sintak15/s3-lora-interface/README.md

# Heltec LoRa Interface

A touchscreen and local web interface for a Heltec Meshtastic radio, built on
an ESP32-S3 CYD. Read messages, check radio and battery status, browse nodes,
and use offline maps without depending on internet access.

**Current firmware: v0.1.112.** The CYD runs this firmware; the Heltec runs
Meshtastic and handles the LoRa radio connection.

Both interfaces use a blue theme with bundled Material Symbols Rounded icons,
rounded cards and consistent navigation feedback. Web Settings opens to five searchable
categories and one editor at a time; Health and SD storage keep detailed
readings under expandable topics. CYD label/value readouts use light blue
labels and white measurements. See the [web UI and display guide](docs/WEB_UI.md).

Battery voltage is measured through an external ADS1115 and a 10k/10k divider.
Only A0 is used for battery sensing; unused A1/A2/A3 are grounded.
Percentage is a rough voltage estimate; no fuel gauge or charging detection is
used. The ATGM336H supplies NMEA positions at 9600 baud. See the
[battery wiring](docs/BATTERY_STATS.md) and [installation checklist](docs/HARDWARE_UPGRADE.md).

## Beginner wiring guide

Follow the [step-by-step beginner wiring guide](docs/WIRING.md) for exact
wire connections, battery-divider assembly, meter checks and troubleshooting
for the build
without DHT22/AM2302, a light sensor, or boosted-5V rail monitoring.
ATGM336H and ADS1115 are the current GPS and battery-sensing hardware.

## Pin mapping — quick reference

For the **LCDWiki 2.8-inch ESP32-S3 CYD** and **Heltec V3.2**. Numbers below
are **GPIO numbers on the named board**, not physical header positions.
All modules share a common ground; UART and I²C signals use 3.3 V logic.

| CYD pin / terminal | Connect to | Purpose |
| --- | --- | --- |
| **GPIO14 — RX** | **Heltec GPIO39 — TX** | Heltec → CYD, 115200 baud |
| **GPIO21 — TX** | **Heltec GPIO38 — RX** | CYD → Heltec, 115200 baud |
| **GPIO3 — GPS RX** | **GPS TX** | GPS → CYD, 9600 baud; positions can be shared over the existing Heltec link |
| **GPIO2** | Leave disconnected | GPS is receive-only; no outside sensor installed |
| **GPIO16 - SDA** | ADS1115 SDA and built-in touch/codec | Shared I2C bus; ADS1115 address 0x48 |
| **GPIO15 — SCL** | ADS1115 SCL; built-in touch/codec | Shared I²C clock |
| **3V3** | ADS1115 VDD | ADC supply and 3.3 V I2C pullups |
| **GND** | Heltec GND, GPS GND and power ground | Common ground |
| **5V** | Boost converter output to CYD/Heltec | GPS VCC must match its breakout input rating |

**Leave GPS RX and Heltec GPIO4 disconnected.** No receiver commands are sent. Enable the Heltec Serial module in **PROTO / Protobuf** mode at
**115200 baud**, with **RX 38 / TX 39**, matching the working Heltec configuration read
on October 25, 2026. The Web UI reads the configured pins or requires both to
be entered explicitly; it does not assume a pair. For CYD GPS sharing, use
**System > GPS > Config > Adv > Use CYD GPS**. The current enclosure has GPS
connected only to the CYD. See [GPS sharing](docs/GPS_SHARING.md) for migration
from the earlier split-wire setup.
See [detailed wiring and battery connections](#wiring) below.

These built-in CYD connections are already routed on the board:

| Built-in function | CYD GPIO assignment |
| --- | --- |
| TFT | CS **10**, DC **46**, MOSI **11**, SCLK **12**, MISO **13**, backlight **45** |
| Touch | SDA **16**, SCL **15**, reset **18**, interrupt **17**; I²C address `0x38` |
| MicroSD | CLK **38**, CMD **40**, D0 **39**, D1 **41**, D2 **48**, D3 **47** |
| Audio clocks | MCLK **4**, BCLK **5**, LRCLK **7** |
| Audio data | **8** ESP32 → codec playback input; **6** codec → ESP32 recording output |
| Audio control | Amplifier enable **1**, active low; codec I²C address `0x18` |

Playback uses GPIO8, matching the
[board schematic](https://www.lcdwiki.com/res/ES3C28P/2.8inch_ESP32-S3_Display_Schematic.pdf).
Connect the speaker to the CYD's dedicated speaker port; these GPIO assignments
describe internal board wiring. See [notification audio](docs/AUDIO.md).

## What it does

- **Home dashboard:** radio status, battery level, node/GPS status and a message
  preview. Tap a card for details, or Menu for the launcher.
- **Messaging:** channel and direct messages, unread counts, delivery states,
  and retry controls where available. Direct messages have per-device conversations
  and drafts on the CYD and web UI.
- **Games:** Tamapetchi and Giraffegotchi beneath a compact live dashboard, plus
  Peanut GB with touch controls and web ROM uploads. See [games](docs/GAMES.md).
- **Notification audio:** soft boops and bubble pops with separate message/direct
  selections, clean volume control, dedicated playback and automatic fault recovery.
- **Offline maps:** SD-backed maps on both the touchscreen and web interface,
  zooms 10–14, feet/miles scales and coarser fallback when detail is missing.
- **Map navigation:** drag to explore, pause/follow the device, recenter and
  inspect actual coverage around the touchscreen map center.
- **Battery monitoring:** ADS1115 cell voltage and approximate percentage; no charging detection or runtime estimate. See [battery monitoring](docs/BATTERY_STATS.md).
- **Local storage:** chat/event logs, position history, saved location and a
  cached map image on FAT32 MicroSD. Supports normal MBR cards and validated
  GPT FAT32 partitions. See [replacement-card verification](docs/SD_REPLACEMENT.md).
- **USB tools:** upload tiles, copy files to a replacement card and inspect
  receiver-level GPS and audio diagnostics.

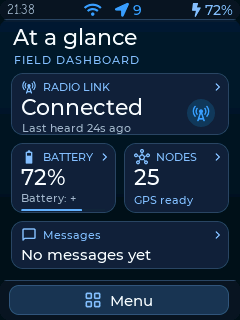
[picture p1: docs/images/home.png]
Touchscreen home dashboard with radio, battery, nodes and messages cards


The launcher contains Messages, Nodes, Map, TX Log, System and Games. Health is under
System. See the [home dashboard guide](docs/HOME_DASHBOARD.md) for details.

## Hardware

The current build uses:

| Component | Purpose |
| --- | --- |
| [LCDWiki 2.8-inch ESP32-S3 display / CYD](https://www.lcdwiki.com/2.8inch_ESP32-S3_Display) | Touchscreen, web interface and SD storage |
| Heltec V3.2 running Meshtastic | LoRa radio |
| ATGM336H GPS breakout and antenna | NMEA location input to CYD |
| ADS1115 breakout, two 10k 1% divider resistors and filter/decoupling capacitors | Battery voltage monitoring |
| Single-cell rechargeable battery, 2500 mAh 18650 in this build | Portable power |
| TP4056 charger and MT3608 5V boost converter | Charging and boosted supply |
| FAT32 MicroSD card, optional | Offline maps and persistent logs |

The verified CYD has 16 MiB flash and 8 MiB PSRAM. Pin assignments below are
specific to this hardware. GPIO numbers are not physical header positions.

## Enclosure

The V4 print set predates the current GPS/ADC hardware. Its mounting envelopes
are historical; check the [ATGM336H/ADS1115 adapters](docs/ENCLOSURE_SENSORS.md)
and verify fit before printing.

[V4 OpenSCAD enclosure](hardware/enclosure/enclosure_v4.scad) uses measured component envelopes,
the single-battery holder, intact power assembly and oval speaker. It provides
visible CYD and Heltec screens, module mounts and separate charging/USB access.
Printed antenna and speaker screw retainers provide mounting without foam.
See the [V4 enclosure guide](docs/ENCLOSURE_V4.md) for previews, exports and
assembly. Print the fit coupon and verify connector/mount offsets before a full
case. The [V3 prototype](docs/ENCLOSURE.md) remains available separately.

Latest fit revisions (earlier STL iterations are retained for reference):

Enclosure sources, printable files and fit coupons are grouped under
[`hardware/enclosure/`](hardware/enclosure/README.md).

- [Current face: tapered GPS supports and 1.8 mm CYD pilots](hardware/enclosure/enclosure-v4-front-gps-tapered-rims.stl).
- [Current base plus two Heltec brackets on one 180 mm plate](hardware/enclosure/enclosure-v4-latest-base-and-heltec-brackets.stl).
- [Existing base alone: breakout screw posts and open battery area](hardware/enclosure/enclosure-v4-base-max-screw-posts.stl).
- [Matching antenna brackets](hardware/enclosure/enclosure-v4-antenna-rails-repair.stl).
- [Speaker retaining frame](hardware/enclosure/enclosure-v4-speaker-frame.stl).

Print at 100% scale in millimetres, keeping the supplied bed orientation.
See the [latest face notes](docs/GPS_TAPERED_RIMS.md) and
[base mounting notes](docs/MAX_SCREW_POSTS.md) for screw sizes and fit checks.
The current designs have geometry checks but are still physical-fit prototypes.

## Build and first connection

1. Install the pinned Arduino dependencies and board configuration from
   [docs/BUILD.md](docs/BUILD.md). LVGL and TFT_eSPI configuration files are
   included in the repository.
2. To customize the device identity and credentials, copy
   `config/device_config.example.h` to `config/device_config.local.h` and edit
   that local file. Git ignores it. Without it, the example configuration is used.
3. Wire and configure the Heltec serial connection as shown below. Enable its
   GPS and configure the GPS pins if the receiver is installed.
4. Build the CYD firmware without changing its version:

   ```powershell
   .\tools\build_ota_bin.ps1 -NoVersionBump
   ```

   The binary is written under `dist/`. You can also use Arduino IDE with the
   board settings documented in the build guide.
5. Flash the CYD, connect to its Wi-Fi access point, and open
   **http://192.168.4.1/**. In station mode, use its assigned local-network address.

With the unchanged example configuration, the Wi-Fi network is
`s3-lora-interface`, the Wi-Fi password is `setup1234`, and the web login is
`admin` / `setup1234`. Complete the first-run setup and change the password.
Custom configurations use their configured network name and credentials.

The web interface includes messaging, nodes, offline maps, health, settings,
SD downloads and firmware upload. The map library and stylesheet are bundled
in firmware, so the web map needs no internet access.

## Wiring

TX connects to RX: one board's transmit wire goes to the other's receive pin.
All boards share a common ground.

### Power and battery monitoring

The documented power path is battery → charger output → 5V boost converter.
The boosted rail supplies the Heltec `5V`, CYD `5V` and the GPS breakout only if its input rating permits 5 V. The CYD USB port does not charge this project's battery; charging uses
the separate charger connection.

Battery sensing uses an external ADS1115 at 0x48 and a 10k/10k divider on A0.
[Wiring and power-off checks](docs/BATTERY_STATS.md) require no CYD modifications.
Keep the CYD battery socket empty while using the external charger.

### CYD ↔ Heltec serial

| CYD | Heltec |
| --- | --- |
| GPIO14 — RX | GPIO39 — TX |
| GPIO21 — TX | GPIO38 — RX |
| GND | GND |

In the Meshtastic serial module, set **Enabled**, **PROTO / Protobuf** mode,
**115200 baud**, **RX pin 38** and **TX pin 39** for this wiring.

### Unused sensor connections

Leave GPIO2 disconnected and ground ADS1115 A1/A2/A3. No outside sensor,
light sensor or 5V monitoring divider is installed. Disable absent outside-sensor
polling with `AM2302_DATA_PIN=-1` in the local configuration; see the
[core wiring guide](docs/WIRING.md).

### GPS

ATGM336H TX connects to CYD GPIO3; GND connects to common system ground.
Leave GPS RX and CYD GPIO2 disconnected. Default is 9600 baud, 8N1, receive-only
NMEA. Supply voltage must match the purchased BREAKOUT's documented rating;
never assume a bare ATGM336H supports 5 V. Confirm its regulator/input labels
before reusing the old GPS supply wire.

Enable **Use CYD GPS** only after checking the Heltec setup as described in
[GPS sharing](docs/GPS_SHARING.md). Position sharing remains available. Receiver
rate/model/power/SBAS/save controls are disabled for ATGM336H; no u-blox commands
are sent. See [GPS configuration](docs/GPS_CONFIG.md),
[GPS diagnostics](docs/GPS_DIAGNOSTICS.md) and
[the installation checklist](docs/HARDWARE_UPGRADE.md).

### Built-in MicroSD slot

| SD signal | CYD GPIO |
| --- | --- |
| CLK | 38 |
| CMD | 40 |
| D0 | 39 |
| D1 | 41 |
| D2 | 48 |
| D3 | 47 |

Use the CYD's built-in slot. These are CYD GPIO assignments, separate from
the similarly numbered Heltec pins.

## Offline maps

Place tiles on the SD card using this structure:

```text
/s3-lora/tiles/{zoom}/{x}/{y}.rgb565
```

Each tile is **256×256 RGB565, little-endian, exactly 131072 bytes**. Supported
zoom levels are **10–14**; lower numbers show a wider area. Preparing new maps
requires a suitable tile source; viewing installed maps is fully offline.

On the touchscreen, use −/+ to change zoom, drag to explore, and use Follow
or My location to resume tracking. Coverage reports installed tiles around the
current center at each level. The requested zoom is retained when a coarser
view is needed. Availability is checked from files, not inferred from a
download plan.

The browser uses the same SD tiles. It preserves your pan position during
status updates and provides My location, Show nodes and Refresh maps controls.
Its Touchscreen coverage card describes the touchscreen's last checked area;
the browser map has its own visible-tile status.

See [touchscreen navigation](docs/MAP_NAVIGATION.md),
[coverage and fallback](docs/MAP_COVERAGE.md), and
[offline browser maps](docs/WEB_OFFLINE_MAPS.md).

### Upload tiles over USB

Install `pyserial`, connect through the **CYD USB port**, and close other serial
monitors. Replace `COM12` and `H:` with the actual port and card-reader drive.

```powershell
python -m pip install pyserial
python tools/upload_tiles_usb.py --port COM12 --tiles H:\s3-lora\tiles
```

The tile folder must contain `z/x/y.rgb565`. Identical tiles are verified and
skipped; add `--overwrite` to replace different existing tiles. Transfers use
CRC checks and SD readback verification. Use `--dry-run` to validate local
paths and sizes without connecting.

For large map packs, downloading directly to a card in a USB reader avoids the
CYD transfer step. The USGS downloader supports resuming and a storage budget,
with a St. Paul-centered coverage profile. See the
[map transfer and replacement-card guide](docs/USB_MAP_TRANSFER.md) for tile
preparation, direct downloads, source attribution and safe stopping/resuming.

### Preserve files when changing cards

To copy supporting files while preparing a new map pack separately:

```powershell
python tools/copy_sd_usb.py --port COM12 --destination H:\ `
  --manifest build/sd-copy-H.jsonl --progress build/sd-copy-H.json `
  --exclude-path /s3-lora/tiles
```

This reads the installed card and preserves directory structure on the new
card. Omit `--exclude-path` to copy existing tiles too. Supporting files can
include chat history and saved locations. Shut down the CYD before swapping
cards, and keep the original card until the replacement is working.

## GPS diagnostics

Open **System → GPS** to inspect receiver bytes, valid NMEA sentences,
checksum errors and available satellite counts before a position fix. Unknown
satellite counts are distinct from zero.

Over the CYD USB connection, the `gps` command reports the same receiver health
and the Heltec's reported GPS pin settings. To record an observation:

```powershell
python tools/gps_diagnostics_usb.py --port COM12 --duration 35 --interval 5 `
  --output build/gps-observation.json
```

The packet-statistics **GPS / Positions** counter measures mesh position
messages, including other nodes. It is not a receiver-fix counter.

| Observation | Next checks |
| --- | --- |
| Receiver bytes stay at zero | GPS power, common ground and GPS TX → CYD GPIO3 |
| Bytes arrive, but valid NMEA does not increase | Baud rate, output protocol and signal integrity |
| Valid sentences arrive, but no fix | Outdoor sky visibility, antenna connection/orientation and GPS supply stability |

The latest recorded observation confirmed valid serial data and the expected
Heltec pin settings, but did **not** acquire a position fix. See
[GPS diagnostics and recorded findings](docs/GPS_DIAGNOSTICS.md) for details.

## Memory and development

Large UI buffers, logs and the map canvas use ESP32-S3 PSRAM. The optional
eight-tile cache holds **1 MiB** in PSRAM; display transfer buffers and task
stacks remain in internal RAM. See the
[measured cache profile](docs/MAP_CACHE_PROFILE.md) for timings and limits.

Build dependencies, verification commands, source layout and hardware checks
are documented in [docs/BUILD.md](docs/BUILD.md). Local device configuration,
generated build identity, binaries, logs and download progress remain outside
Git under the configured ignore rules.

See the [documentation index](docs/README.md) for current guides and historical
reviews, and [contribution conventions](CONTRIBUTING.md) for naming, file
placement and verification before committing.

The bundled Leaflet viewer retains its license in
[src/vendor/leaflet/LICENSE](src/vendor/leaflet/LICENSE).
