sintak15/s3-lora-interface/docs/README.md

# Documentation index

The [project README](../README.md) contains the hardware overview, wiring and
first connection. These guides describe the current firmware unless marked as
historical.

## Hardware wiring

- [Beginner wiring: exact connections, battery divider, meter checks and troubleshooting](WIRING.md)
- [Expanded sensor installation checklist](HARDWARE_UPGRADE.md)

## Firmware and operation

- [Build, verification and source layout](BUILD.md)
- [Web navigation, rounded icons, blue theme and CYD label/value colors](WEB_UI.md)
- [Notification boops, pops and audio diagnostics](AUDIO.md)
- [ADS1115 battery voltage and approximate percentage](BATTERY_STATS.md)
- [GPS Config and Adv settings](GPS_CONFIG.md)
- [CYD GPS sharing and removing the split wire](GPS_SHARING.md)
- [GPS wiring, diagnostics and USB control](GPS_DIAGNOSTICS.md)
- [Heltec firmware updates and installed-loader limits](HELTEC_UPDATES.md)
- [Home dashboard](HOME_DASHBOARD.md)
- [Touchscreen map navigation](MAP_NAVIGATION.md)
- [Offline coverage and fallback](MAP_COVERAGE.md)
- [Tile cache and measured performance](MAP_CACHE_PROFILE.md)
- [Offline browser maps](WEB_OFFLINE_MAPS.md)
- [USB map transfer, replacement cards and resumable downloads](USB_MAP_TRANSFER.md)
- [Naming, file placement and contribution checks](../CONTRIBUTING.md)

## Enclosure and printing

Start with the [enclosure file index](../hardware/enclosure/README.md) for current
print parts, earlier variants and fit coupons. The
[V4 enclosure guide](ENCLOSURE_V4.md) describes the mechanical assembly;
[paper templates and fit trays](fit-template/3D-PRINT.md) support fit checks.

## Historical records

These retain the observations, version and limitations recorded at the time.
Line references in dated reviews refer to that reviewed source revision.

- [Heltec message/restart investigation — October 24, 2026](MESSAGE_RESTART_REVIEW_2026-10-24.md)
- [Firmware implementation history](FIRMWARE_HISTORY.md)
- [Project review — October 23, 2026](PROJECT_REVIEW_2026-10-23.md)
- [Audio investigation — October 23, 2026](AUDIO_REVIEW_2026-10-23.md)
- [Photo and mechanical-fit review — October 21, 2026](PHOTO_FIT_REVIEW_2026-10-21.md)
- [V3 enclosure prototype](ENCLOSURE.md)
