sintak15/s3-lora-interface/docs/GPS_SOLID_RIMS.md

# Filled NEO-6M post rims

Historical mechanical revision: these dimensions describe earlier hardware.
For current ATGM336H/ADS1115 connections use the [wiring guide](WIRING.md);
verify replacement-module fit with the [adapter guide](ENCLOSURE_SENSORS.md).

Full face: `hardware/enclosure/enclosure-v4-front-gps-solid-rims.stl`.
Small test: `hardware/enclosure/enclosure-v4-gps-solid-rims-coupon.stl`.

The two screenshot-marked recesses beside the NEO-6M screw holes are filled.
The receiver posts have full 6 mm outside-diameter caps from Z=13.6 to their
unchanged Z=18 seating plane, except for the intended 1.6 mm screw pilots.
All 3.2 mm of pilot depth is enclosed by the solid caps; nominal radial wall
around the pilot is 2.2 mm (slightly flattened on the adjacent CYD side).

Lower recesses remain for the complete 25 × 25 × 7.5 mm antenna and its feed.
The flat antenna sits at Z=3.8–11.3; feed relief extends to 13.3, with another
0.3 mm allowance before the filled cap starts. The rest of the right-shifted
layout and all board mounting centres and heights remain unchanged.

Use current M2 × 4 mm NEO-6M screws. Existing antenna brackets and the latest
base remain compatible. The newly filled caps have underside overhangs:
inspect the layer preview and use local supports under these caps as needed.
Print exterior face down, 100% scale, 0.2 mm layers and 4 walls. Keep support
out of the pilot holes. Physical fit and strength have not been load tested.
