sintak15/s3-lora-interface/docs/WEB_UI.md

# Web UI and display

Firmware uses a navy/blue palette on both the CYD and its local web UI.
Open the CYD's IP address in a browser and use its configured web login.

## Theme and icons

v0.1.104 adds Material Symbols Rounded to the home dashboard, main navigation,
system menus and page headings, with matching icons in web navigation, Settings
categories, status cards and diagnostic topics. Every navigation control keeps
its text label. The CYD main menu keeps all six destinations on one screen;
denser system menus scroll to accommodate an icon above each full-width label.

Cards, panels and buttons share rounded corners and blue pressed/selected states.
CYD press feedback changes colors without enlarging touch targets. Browser
transitions respect the operating system's reduced-motion preference. The larger
text modes, blue diagnostic labels/white readings, amber/red warnings, plain
battery symbols and message-direction colors remain in place.

Icons are bundled in firmware and work offline. The browser uses inline SVGs;
the CYD uses 16/20/24-pixel alpha masks, so there is no runtime SVG decoder or
external font download. Only 28 selected icons are included, using 17,248 bytes
of pixel masks before metadata. The unchanged source SVGs, pinned upstream
commit, hashes and Apache 2.0 license are in
[the Material Symbols directory](../src/vendor/material-symbols/README.md).
Regenerate both asset formats with `python tools/generate_ui_icons.py`; add
`--check` to verify them. Generation requires Pillow, Playwright and Chromium.

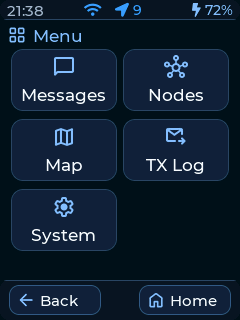
[picture p4: docs/images/menu.png]
CYD main menu with rounded blue icon tiles and readable labels


## Finding settings

**Settings** is a main navigation destination. Its landing page offers five
categories rather than displaying every configuration field:

| Category | Editors |
| --- | --- |
| Radio & location | Radio/identity, channels, GPS/position |
| Device & screen | CYD interface, Heltec behavior, Heltec display, Heltec power |
| Connections | Heltec Wi-Fi, Bluetooth, serial link, MQTT |
| Messages & alerts | External alerts, store/forward, canned messages, status message |
| Sensors & tools | Telemetry, detection sensor, ambient LED, Heltec voice audio, Paxcounter, neighbor information, range test |

Choose a category, then an editor. Only that editor is shown. **All settings**
returns to the category list; the category button returns to its section list.
Search finds sections by their titles, descriptions and field labels. Selecting
a result also opens an advanced group when the matching field is inside it.
Changing editors keeps drafts in the browser, including pending passwords.
Background status updates do not erase those drafts.

The CYD interface editor controls the CYD's identity, access point and web login.
Editors explicitly named Heltec control the connected Meshtastic radio. Heltec
voice audio is separate from the CYD's notification sounds.

Common fields appear first. Advanced groups hold GPS timing, serial pins, sleep
timings, display details, MQTT extras, notification outputs and telemetry
reporting intervals. Their values still load from the radio and remain included
when their section is applied. Blank password fields retain existing secrets.
Apply/save feedback appears above the active editor. A lost connection reports
an unknown outcome; refresh settings before repeating the change.

Serial RX/TX fields start blank until valid Heltec configuration is received.
If the link is down, enter both pins to match the wiring. Applying the serial
module never substitutes a default pin pair; requests missing either pin are
rejected. Background refreshes preserve edited pins until matching radio
readback arrives. GPS sharing accepts distinct, nonzero configured RX/TX pins
with PROTO at 115200 baud and a responsive radio link.

Channel Save remains in its editor. General save/restart and diagnostic commands
are under **Tools > Serial console > Heltec commands**.

## Health and maintenance

**Tools** contains Health & diagnostics, SD storage, event logs, serial console
and firmware update. The menu closes when a destination is selected, when
Escape is pressed or when another part of the page is clicked.

Health initially shows eight essential readings. Battery/runtime, GPS/position,
radio traffic/serial data, maps/cache, system resources and audio/hardware tests
have separate expandable topics. Field reports remain directly downloadable.
SD storage initially shows status, type, usage and capacity; saved files and
maintenance counters have their own expandable groups.

The Battery & runtime topic shows Battery: +, Battery: - and
Battery: = indicators, sampled voltage variation and automatic logging status.
The retention checkbox rotates after 48 hours of powered-on recording; disabling
it keeps the current log growing. Current and previous readable/CSV downloads
remain available. On the CYD, **System > Battery > View logs** opens a scrollable
recent log with **Current log**, **Previous log** and **Refresh log** controls.
See [battery statistics](BATTERY_STATS.md) for retention and measurement limits.

## Clear controls and message direction

Use plain action-and-object labels that explain the result of tapping a control.
When space is tight, use a separate page or a short visible explanation instead
of an ambiguous abbreviation. Settings that change retention must say so and
remain separate from the automatic measurement status. This is the standing
labeling preference for future interface changes.

Public, secondary-channel and direct-message histories use light blue
(`#85BFFF`) for this device's messages and white (`#F4F8FF`) for messages from
other devices. A visible web legend explains the colors, and persisted sender
labels remain readable without color. New incoming entries are marked `from`
and outgoing/local-echo entries use `me`, based on the actual node direction.
A remote node named `me` is still an incoming entry. Multiline content remains
part of its original message, and literal HTML/LVGL color commands are escaped.
Raw SD message logs keep plain text; colors are applied only while displaying.

## CYD label/value colors

Structured readouts use light blue (`#85BFFF`) for the label, including its
colon, and white (`#F4F8FF`) for the reading on the same line. For example,
**Charge rate:** and **3.14%/hr** have different colors. This covers battery,
GPS, Wi-Fi, interface/memory/SD statistics, serial/radio statistics, mesh health,
node details, message diagnostics, channel readouts, map coverage, brightness,
sound volume and receiver-current-setting readouts. Existing warning/fault
indicators retain amber/red. The palette also covers home cards, navigation,
inputs, keyboard, node lists and map markers; map imagery keeps its source colors.

The shared `DiagnosticText` formatter distinguishes field-label colons from
colons inside MAC addresses and times. It also handles multiple label/value
pairs on a line. Literal `#` characters in values are escaped before LVGL
recoloring, so SSIDs and node names remain literal data. Formatting uses a
bounded shared UI buffer; an oversized future readout falls back to complete
plain text rather than truncating its measurements. Editable inputs and freeform
message/log bodies retain ordinary text handling.

## Verification

v0.1.104 passed all 74 actual-device layout cases across both text modes,
including icon bounds, diagnostic screens, long Home states and detailed node
rows. The native Home, navigation and scroll checks passed. Browser checks at
390 and 1280 pixels verified icons inside their controls, accessible text labels,
reduced-motion styling, retained edits, offline maps and diagnostic colors.
Read-only checks against the installed device also passed at both widths, with
no browser errors or external asset requests. Updated Home/menu images were
captured from pixels sent to the CYD display.

Production v0.1.104 was installed over Wi-Fi on October 24, 2026. The radio link
returned responsive, continuous SD recording resumed, and gauge/radio/audio/SD
error counters remained zero in the final check. CYD preferences and cached
Heltec/channel configuration matched the pre-update snapshot. The installed
HTML matched the reviewed source, and verification-only inspection routes
returned 404. The production image is
`dist/s3-lora-interface-rounded-theme-v0.1.104-20261024.bin` (1,928,544 bytes),
SHA-256 `b8668ae06626f75d575dcd9201c146b72943fb7b55a61c5130b62e6191d01d28`.

The original live v0.1.96 Settings page exposed 158 controls, including a single
46-control additional-modules form. It measured 15,366 pixels tall at 390 px
width. The new landing page shows five categories, retains all existing controls
across 22 editors, and measures under 1,500 pixels in the browser layout checks.

`tests/test_web_navigation.py` exercises desktop/mobile navigation, advanced
search results, all editors, draft/secret preservation, module save requests,
the channel shortcut, grouped diagnostics, label/value colors, UTF-8 symbols and
the initial-password setup restriction. Existing browser tests cover status
polling, escaping, retries, sound previews and offline maps. Compile-time
`DiagnosticTextTests.h` checks label boundaries, literal data and buffer limits.
See [build and verification](BUILD.md) for the commands.

### Installed-device verification

On October 23, 2026, v0.1.97 was installed over authenticated Wi-Fi on
`192.168.1.192`. The CYD booted from `app1`; its radio link remained responsive,
SD storage was available, and its local GPS had a fresh fix with ten satellites.
Reported CYD identity, network and sound preferences, the cached Heltec
configuration and channel summaries matched the snapshot taken before upload.

Read-only browser checks against the installed device passed at 390 px and
1,280 px widths: category navigation, one visible editor, advanced-field search,
eight summary diagnostics and the blue-label/white-value colors. The mobile
Settings landing page measured 1,150 px, versus the previous 15,366 px. Neither
viewport produced JavaScript errors or configuration writes. The firmware build,
compile-time readout tests, web regressions and offline-map browser checks also
passed. The physical CYD display has not been visually inspected for this release.

GPS sharing reported **Use CYD GPS setup required** both before and after this
update: the Heltec's existing position configuration had GPS mode `ENABLED`.
The UI update preserved that configuration; it did not rerun the GPS-sharing
setup or verify new relay acknowledgements. Local CYD GPS reception was working.

The installed application is 1,871,040 bytes; its SHA-256 is
`81923f511a5de53aa77e536fffa12e296425a16d7b195332f6c9b901df4ab821`.

## Stable scrolling and text sizing (v0.1.102)

CYD live readouts wait while a finger is down, until scrolling momentum ends,
and while an options dropdown is open.
Nodes refreshes keep the visible node and its offset, including when new nodes
sort above it or compact/detail row heights change. Removing an anchor clamps
the old position to the available content. Changing Sort/Filter or explicitly
clearing the list starts at the top. Returning from node details keeps position.

Pages own vertical scrolling; decorative panels pass drags to the page and
readout panels grow with their text. Touch focus no longer scrolls a button into
view. Pages, lists and read-only text avoid elastic overscroll. Chat follows new
messages while at the bottom and preserves position when reading older entries.

Default text is one pixel larger: CYD Comic Neue 12/14 becomes 13/15 px, and
Readable mode Montserrat 14/16 becomes 15/17 px. Home small text becomes 11 px
and message previews 15 px; large dashboard headings retain their separate size.
Web text sizes also increase by one CSS pixel. Battery symbols use regular weight.

## Games and direct conversations (v0.1.107)

**Games** lists SD Game Boy ROMs and accepts authenticated `.gb` uploads up to
4 MiB. Uploads validate names, cartridge headers and declared size before an
atomic rename. Existing ROMs require explicit deletion before replacement;
deleting a ROM retains its save file. See [games](GAMES.md) for paths and limits.

**Messages > Direct** selects a particular peer, shows its recent history and
keeps its draft. Changing peers also changes the reply recipient. Late responses
for an earlier selection cannot replace the visible conversation. Reading one
conversation marks only that peer read. Old mixed history remains available as
**Earlier messages**.

Authenticated `GET /sd/list?path=/&cursor=0` provides a paginated directory
listing (64 entries per page); `GET /sd/file?path=/...` exports a file. These
read-only routes support copying existing data to a replacement card while
preserving a newly downloaded map pack. They do not modify the old card.
