sintak15/s3-lora-interface/hardware/enclosure/sensors-exploded.png

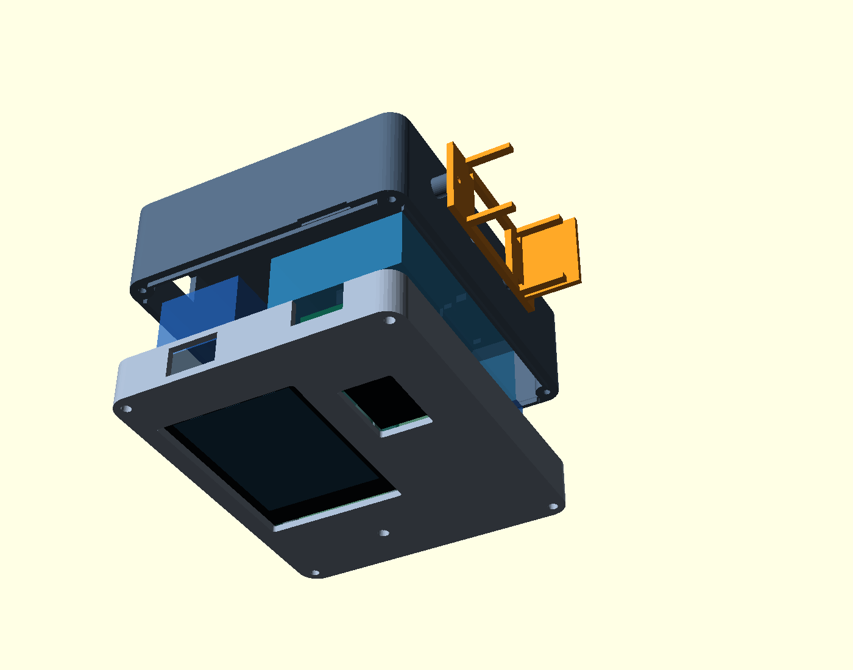
hardware/enclosure/sensors-exploded.png
