sintak15/s3-lora-interface/hardware/enclosure/enclosure-v4-remaining-parts.stl

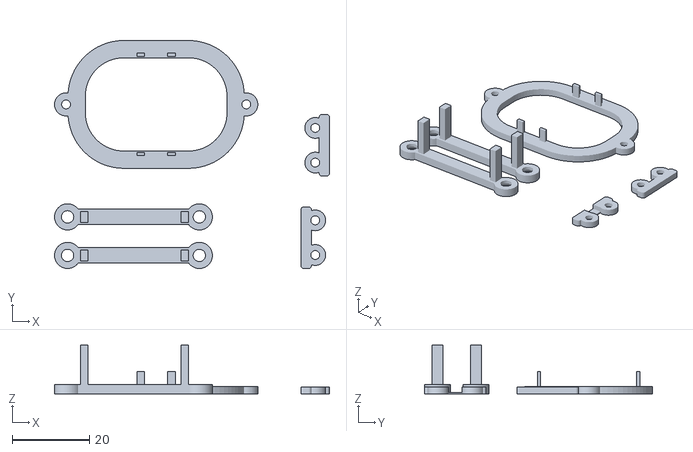
[picture p8: CAD file, 2026-10-23]
hardware/enclosure/enclosure-v4-remaining-parts.stl
71.4 x 59.2 x 12.7
