sintak15/s3-lora-interface/enclosure-v4-antenna-ledges-coupon.stl

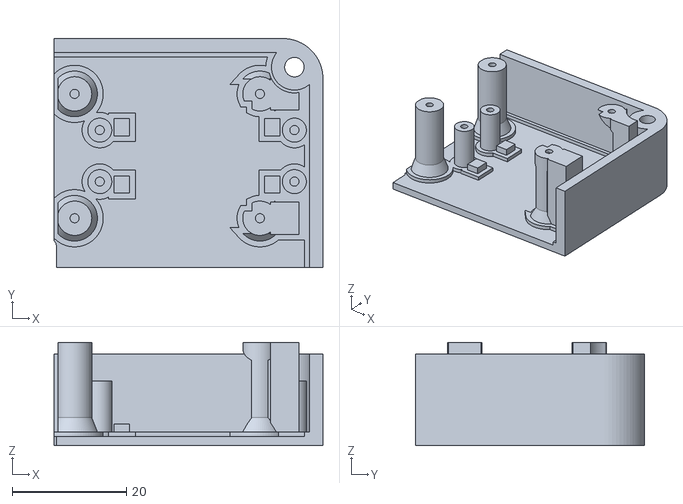
[picture p9: CAD file, 2026-10-23]
enclosure-v4-antenna-ledges-coupon.stl
47.0 x 40.0 x 18.0
