sintak15/s3-lora-interface/fit-coupons/all-coupons-labeled-180mm.stl

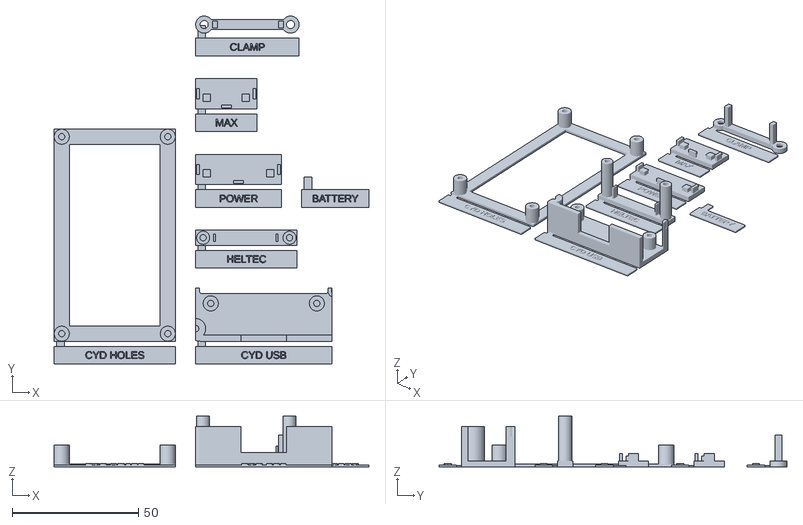
[picture p10: CAD file, 2026-10-23]
fit-coupons/all-coupons-labeled-180mm.stl
124.6 x 137.8 x 20.1
