sintak15/s3-lora-interface/fit-coupons/lightweight/heltec_clamp.stl

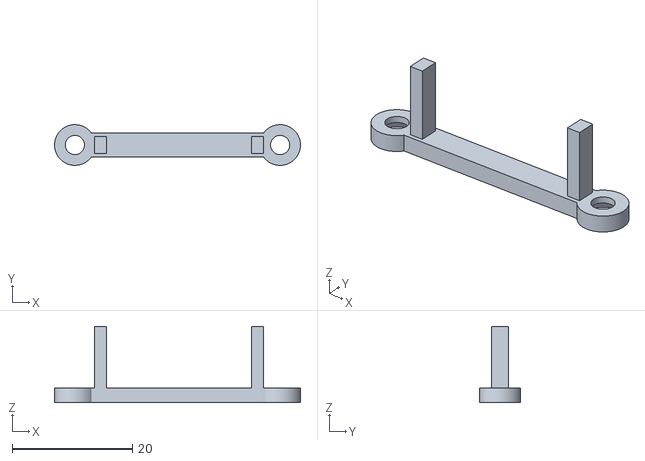
[picture p11: CAD file, 2026-10-23]
fit-coupons/lightweight/heltec_clamp.stl
41.0 x 6.80 x 12.7
