sintak15/s3-lora-interface/hardware/enclosure/fit-coupons/all-coupons-180mm.stl

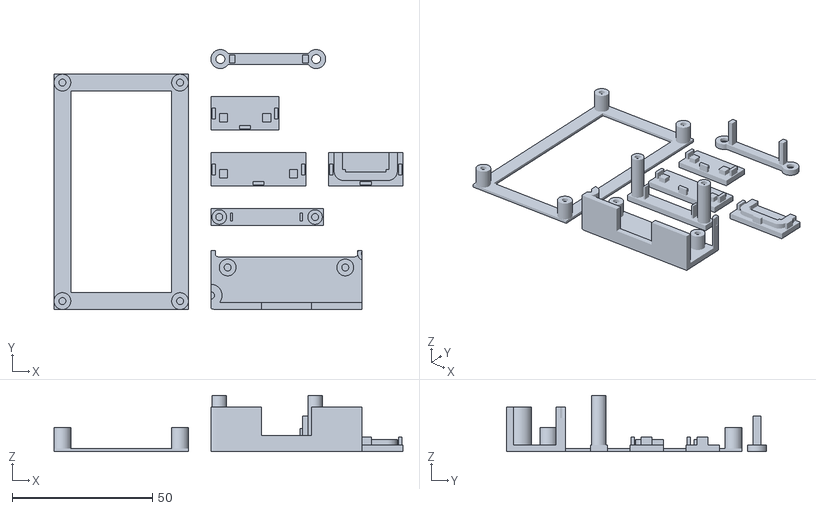
[picture p12: CAD file, 2026-10-23]
hardware/enclosure/fit-coupons/all-coupons-180mm.stl
124.6 x 92.8 x 20.1
