sintak15/s3-lora-interface/hardware/enclosure/fit-coupons/labeled/power.stl

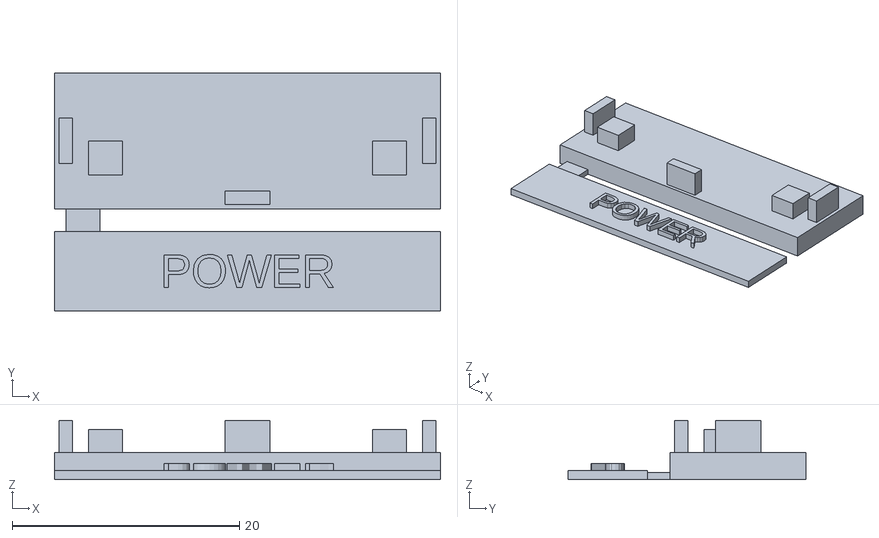
[picture p13: CAD file, 2026-10-23]
hardware/enclosure/fit-coupons/labeled/power.stl
34.0 x 21.0 x 5.20
