sintak15/s3-lora-interface/hardware/enclosure/fit-coupons/lightweight/all-coupons-labeled-180mm.stl

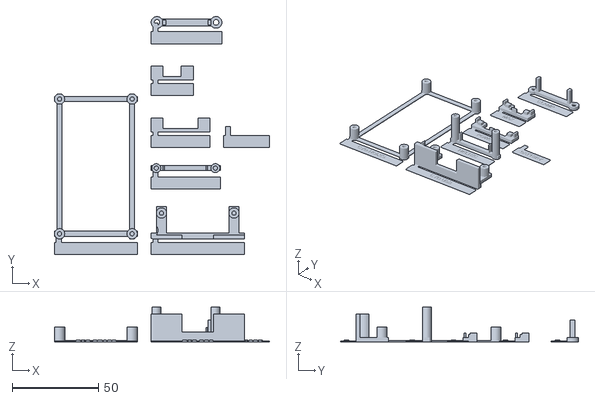
[picture p14: CAD file, 2026-10-23]
hardware/enclosure/fit-coupons/lightweight/all-coupons-labeled-180mm.stl
124.6 x 137.8 x 20.1
