sintak15/s3-lora-interface/hardware/enclosure/sensors-retrofit_gps.stl

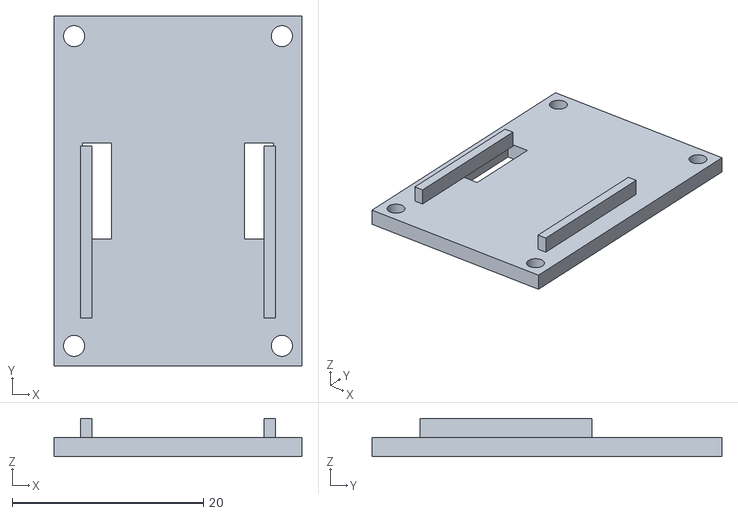
[picture p16: CAD file, 2026-11-07]
hardware/enclosure/sensors-retrofit_gps.stl
25.9 x 36.6 x 4.00
