sintak15/s3-lora-interface/enclosure-v4-front-posts-lowered-5p2mm.stl

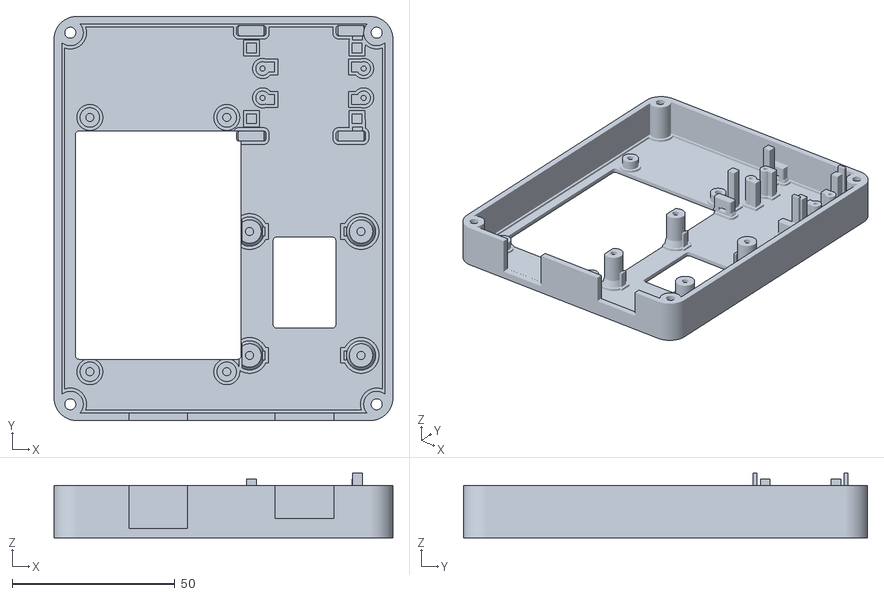
[picture p17: CAD file, 2026-10-23]
enclosure-v4-front-posts-lowered-5p2mm.stl
104.0 x 124.0 x 19.9
