sintak15/s3-lora-interface/fit-coupons/lightweight/max.stl

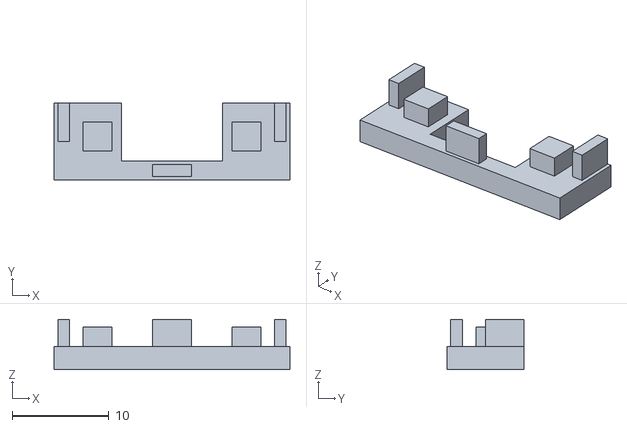
[picture p18: CAD file, 2026-10-23]
fit-coupons/lightweight/max.stl
24.4 x 8.00 x 5.20
