sintak15/s3-lora-interface/hardware/enclosure/fit-coupons/labeled/max.stl

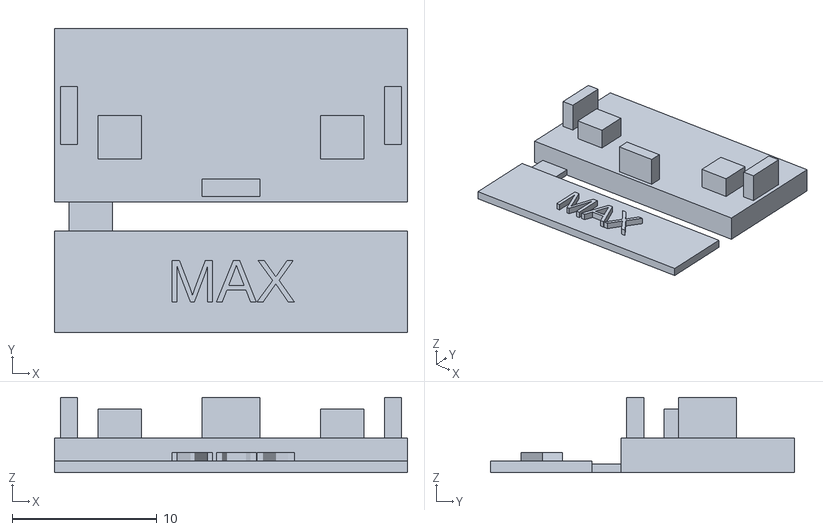
[picture p20: CAD file, 2026-10-23]
hardware/enclosure/fit-coupons/labeled/max.stl
24.4 x 21.0 x 5.20
