sintak15/s3-lora-interface/hardware/enclosure/fit-coupons/lightweight/cyd_mounts.stl

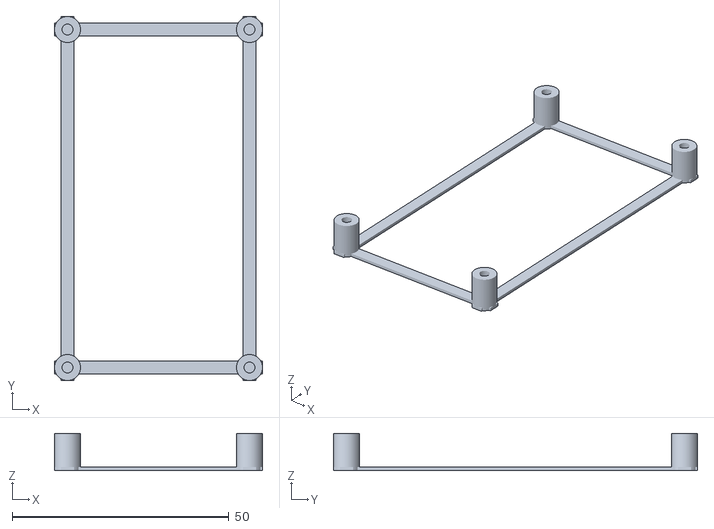
[picture p21: CAD file, 2026-10-23]
hardware/enclosure/fit-coupons/lightweight/cyd_mounts.stl
48.0 x 84.0 x 8.60
