sintak15/s3-lora-interface/hardware/enclosure/fit-coupons/lightweight/labeled/cyd_mounts.stl

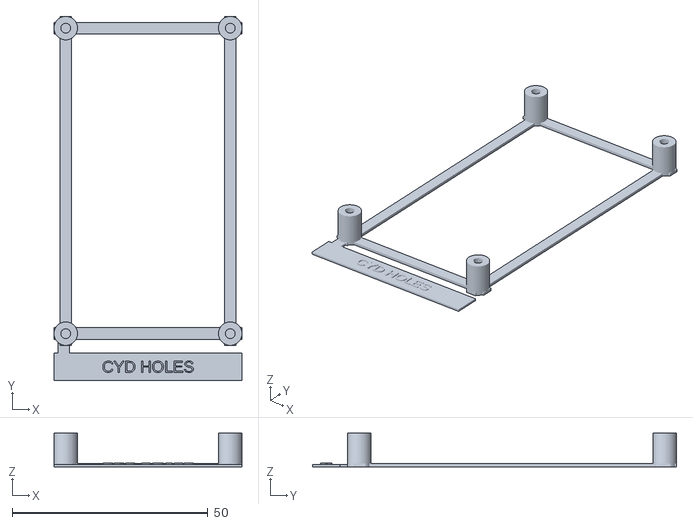
[picture p22: CAD file, 2026-10-23]
hardware/enclosure/fit-coupons/lightweight/labeled/cyd_mounts.stl
48.0 x 93.0 x 8.60
