sintak15/s3-lora-interface/hardware/enclosure/sensors-retrofit_ads.stl

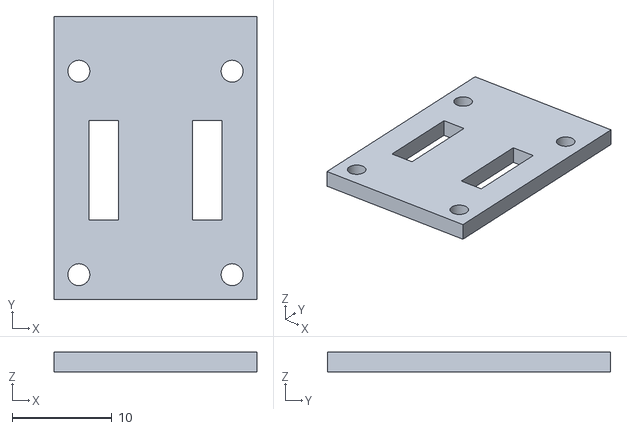
[picture p23: CAD file, 2026-11-07]
hardware/enclosure/sensors-retrofit_ads.stl
20.4 x 28.5 x 2.00
