sintak15/s3-lora-interface/fit-coupons/lightweight/heltec_screen.stl

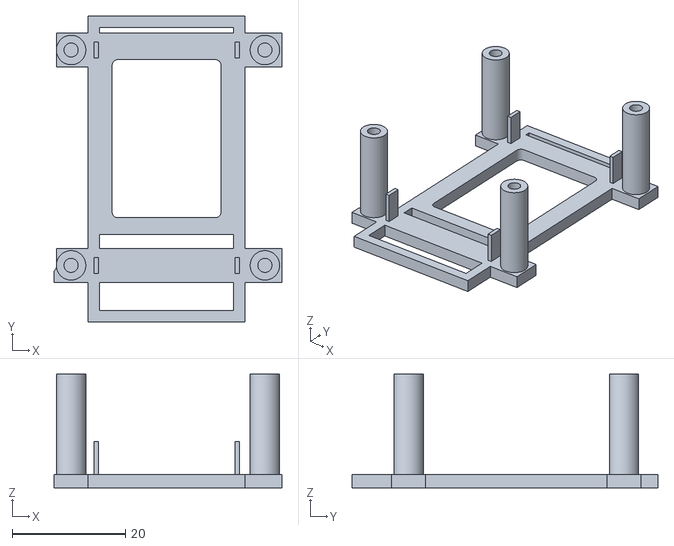
[picture p24: CAD file, 2026-10-23]
fit-coupons/lightweight/heltec_screen.stl
40.2 x 54.0 x 20.1
