sintak15/s3-lora-interface/hardware/enclosure/fit-coupons/labeled/heltec.stl

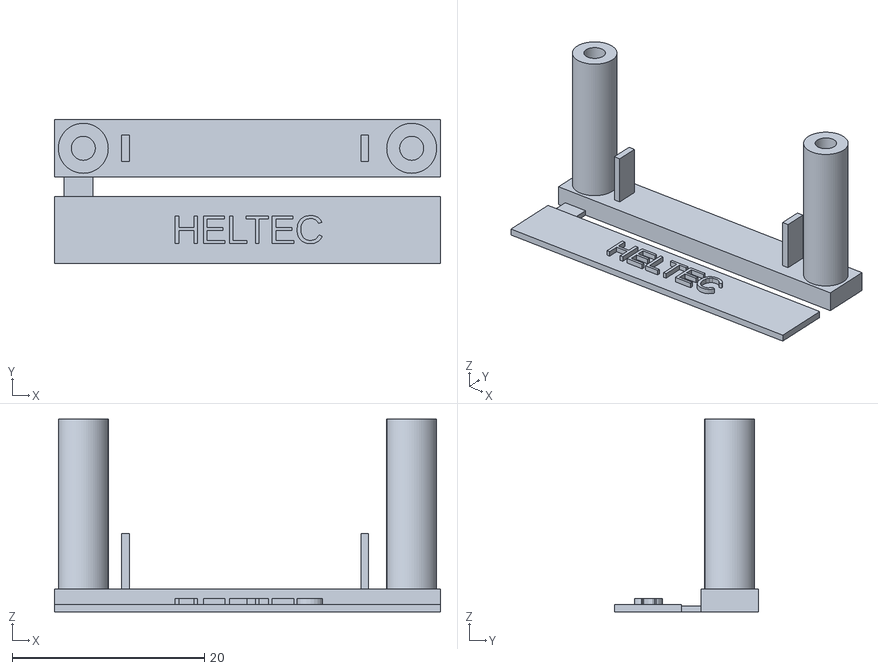
[picture p26: CAD file, 2026-10-23]
hardware/enclosure/fit-coupons/labeled/heltec.stl
40.2 x 15.0 x 20.1
