sintak15/s3-lora-interface/hardware/enclosure/fit-coupons/lightweight/labeled/heltec_clamp.stl

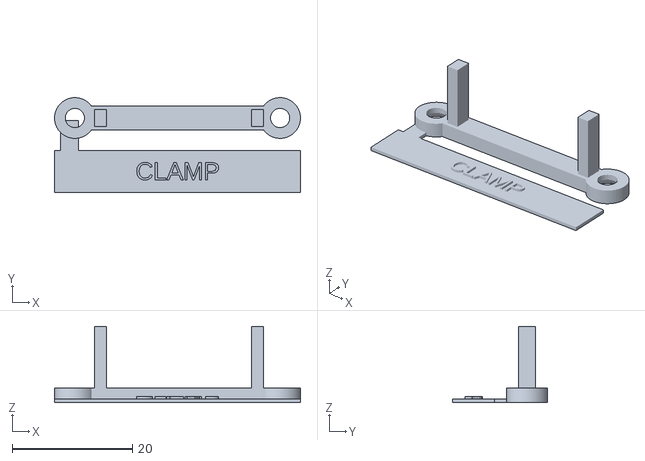
[picture p27: CAD file, 2026-10-23]
hardware/enclosure/fit-coupons/lightweight/labeled/heltec_clamp.stl
41.0 x 15.8 x 12.7
