sintak15/s3-lora-interface/hardware/enclosure/fit-coupons/lightweight/power.stl

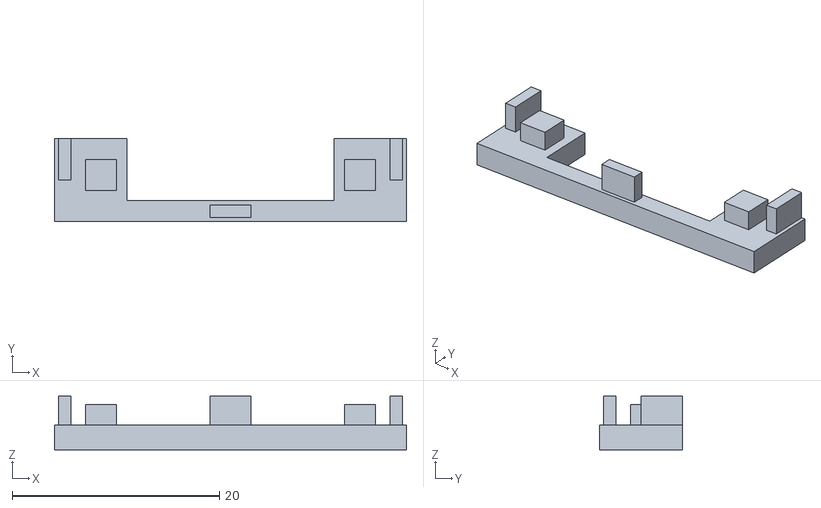
[picture p28: CAD file, 2026-10-23]
hardware/enclosure/fit-coupons/lightweight/power.stl
34.0 x 8.00 x 5.20
