sintak15/s3-lora-interface/hardware/enclosure/sensors-gps_retainer.stl

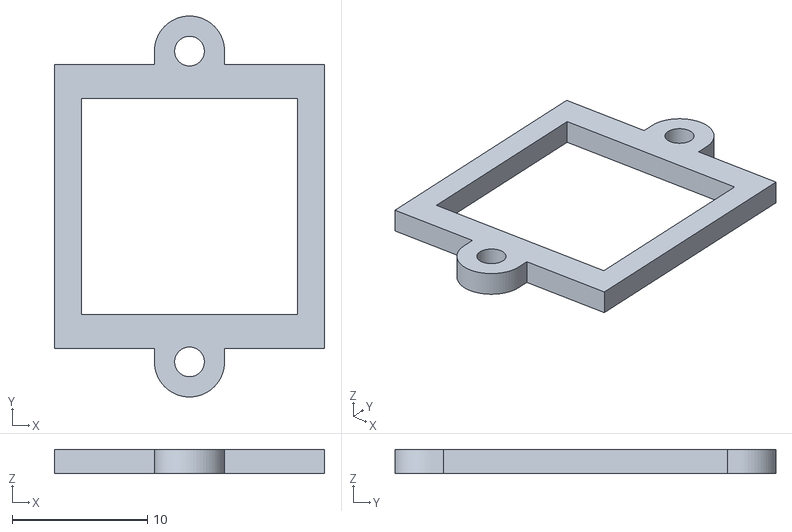
[picture p29: CAD file, 2026-11-07]
hardware/enclosure/sensors-gps_retainer.stl
20.0 x 28.2 x 1.80
