sintak15/s3-lora-interface/enclosure-v4-base-open-battery.stl

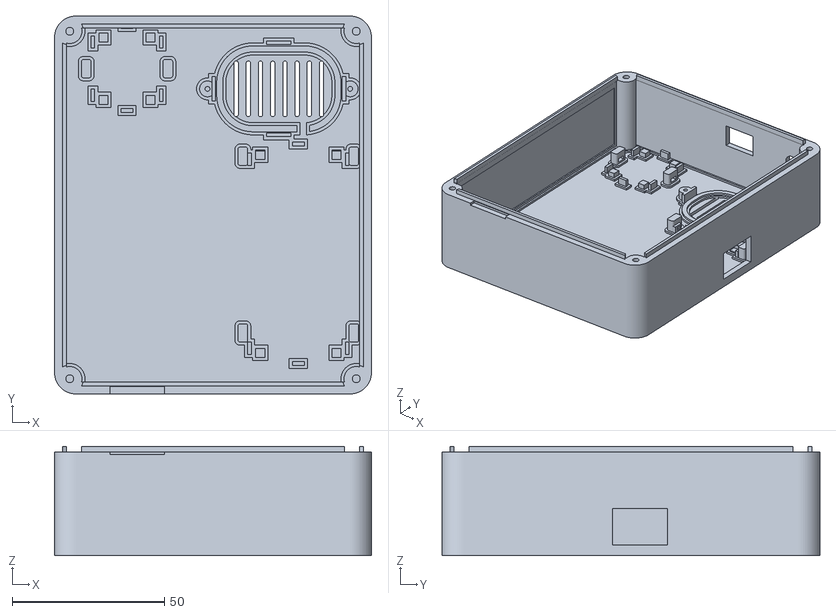
[picture p30: CAD file, 2026-10-23]
enclosure-v4-base-open-battery.stl
104.0 x 124.0 x 35.8
