sintak15/s3-lora-interface/fit-coupons/lightweight/battery.stl

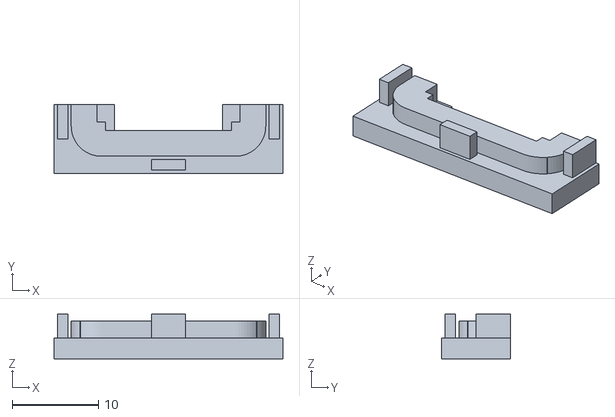
[picture p31: CAD file, 2026-10-23]
fit-coupons/lightweight/battery.stl
26.6 x 8.00 x 5.20
