sintak15/s3-lora-interface/hardware/enclosure/fit-coupons/lightweight/cyd_usb.stl

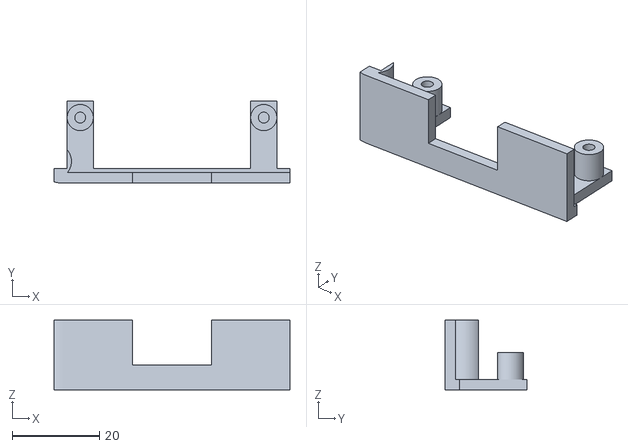
[picture p32: CAD file, 2026-10-23]
hardware/enclosure/fit-coupons/lightweight/cyd_usb.stl
54.0 x 18.8 x 16.0
