sintak15/s3-lora-interface/hardware/enclosure/fit-coupons/lightweight/labeled/power.stl

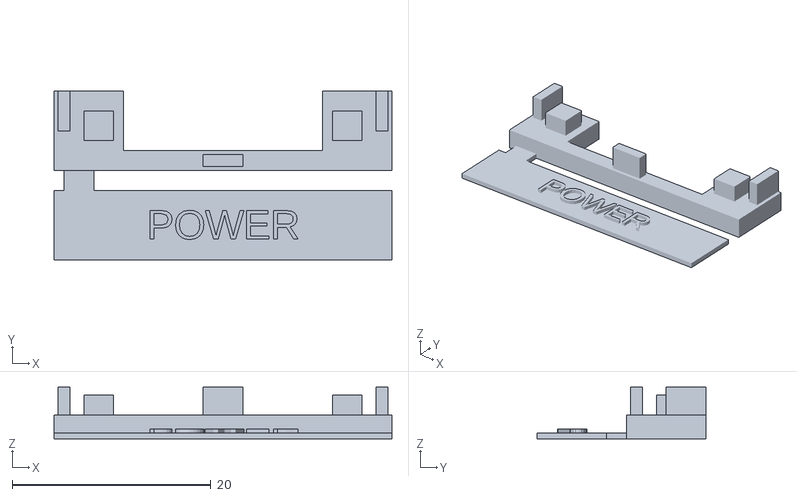
[picture p33: CAD file, 2026-10-23]
hardware/enclosure/fit-coupons/lightweight/labeled/power.stl
34.0 x 17.0 x 5.20
