sintak15/s3-lora-interface/hardware/enclosure/fit-coupons/power.stl

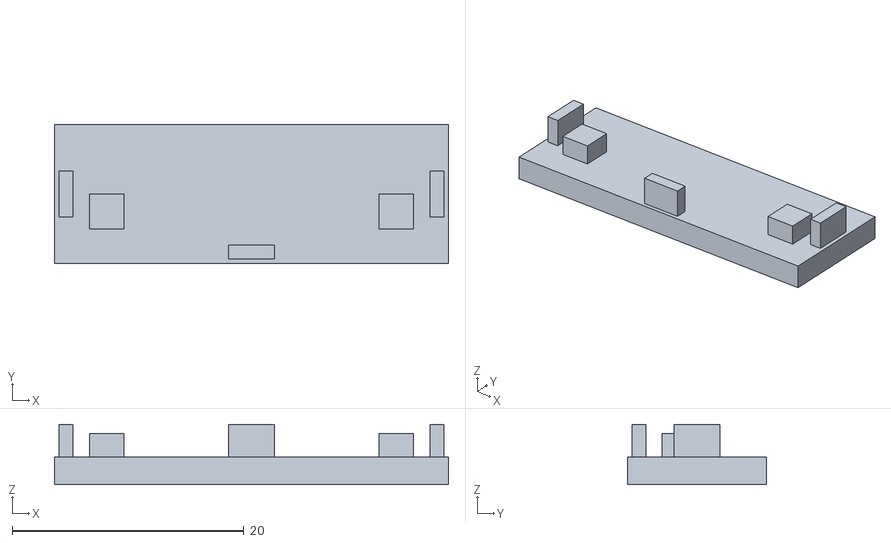
[picture p34: CAD file, 2026-10-23]
hardware/enclosure/fit-coupons/power.stl
34.0 x 12.0 x 5.20
