sintak15/s3-lora-interface/hardware/enclosure/sensors-back.stl

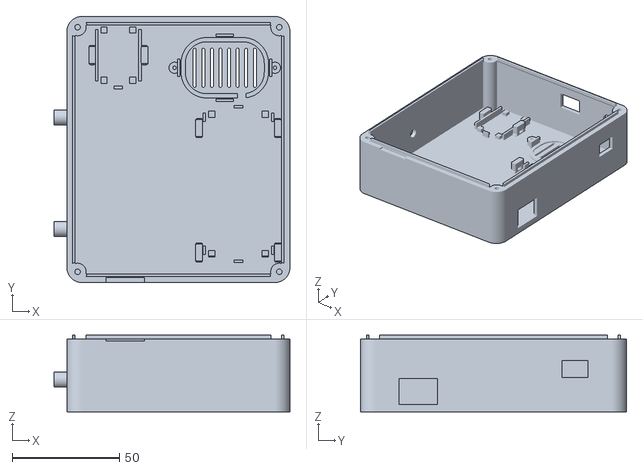
[picture p35: CAD file, 2026-11-07]
hardware/enclosure/sensors-back.stl
110.0 x 124.0 x 35.8
