sintak15/s3-lora-interface/fit-coupons/lightweight/all-coupons-screen-fit-180mm.stl

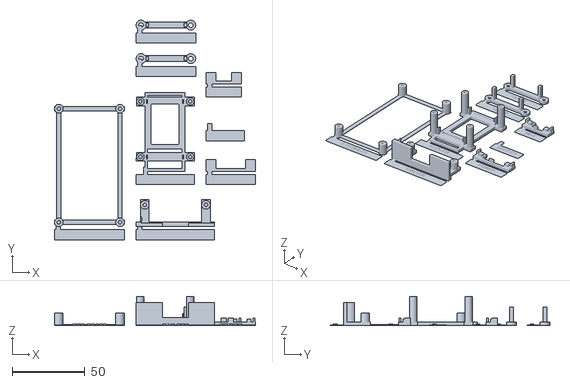
[picture p36: CAD file, 2026-10-23]
fit-coupons/lightweight/all-coupons-screen-fit-180mm.stl
138.0 x 150.8 x 20.1
