sintak15/s3-lora-interface/hardware/enclosure/fit-coupons/heltec.stl

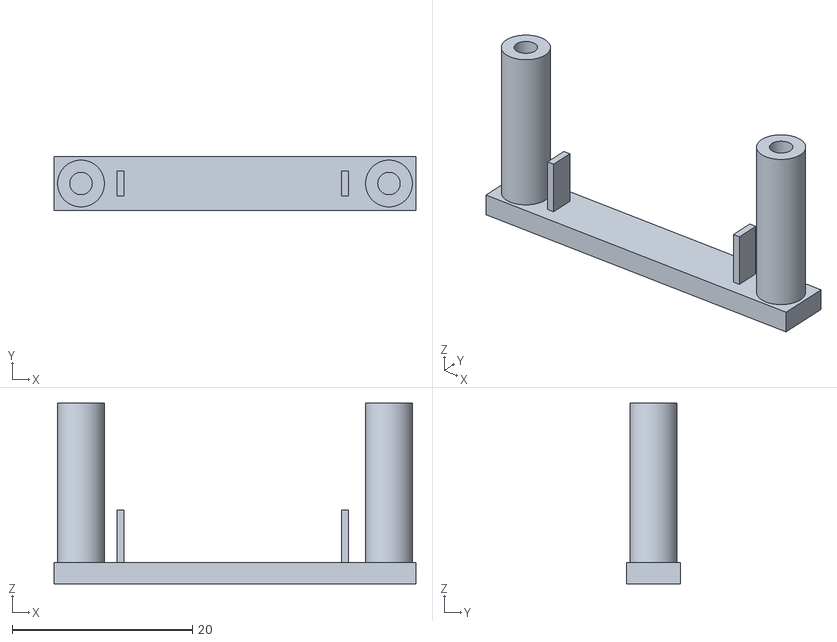
[picture p37: CAD file, 2026-10-23]
hardware/enclosure/fit-coupons/heltec.stl
40.2 x 6.00 x 20.1
