sintak15/s3-lora-interface/hardware/enclosure/fit-coupons/labeled/battery.stl

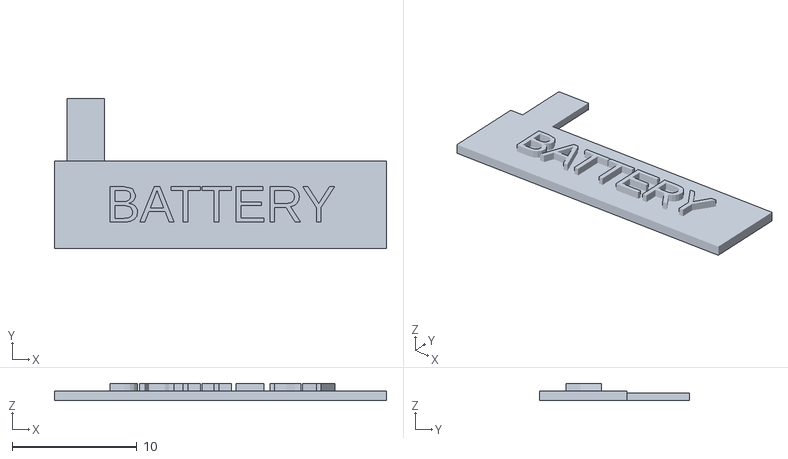
[picture p38: CAD file, 2026-10-23]
hardware/enclosure/fit-coupons/labeled/battery.stl
26.6 x 12.0 x 1.40
