sintak15/s3-lora-interface/hardware/enclosure/fit-coupons/lightweight/heltec.stl

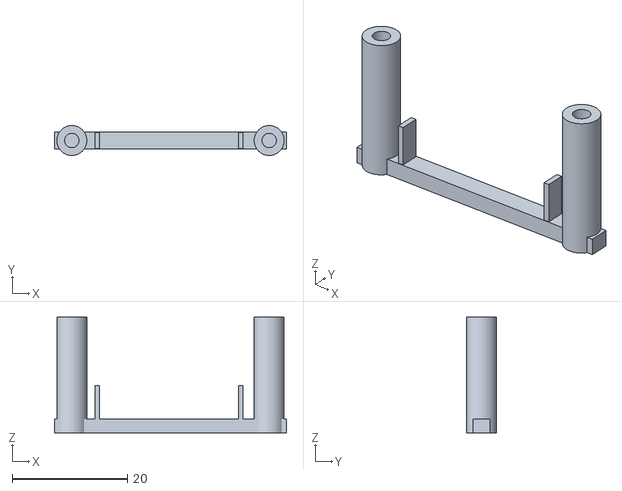
[picture p39: CAD file, 2026-10-23]
hardware/enclosure/fit-coupons/lightweight/heltec.stl
40.2 x 5.20 x 20.1
