sintak15/s3-lora-interface/hardware/enclosure/fit-coupons/lightweight/labeled/heltec_screen.stl

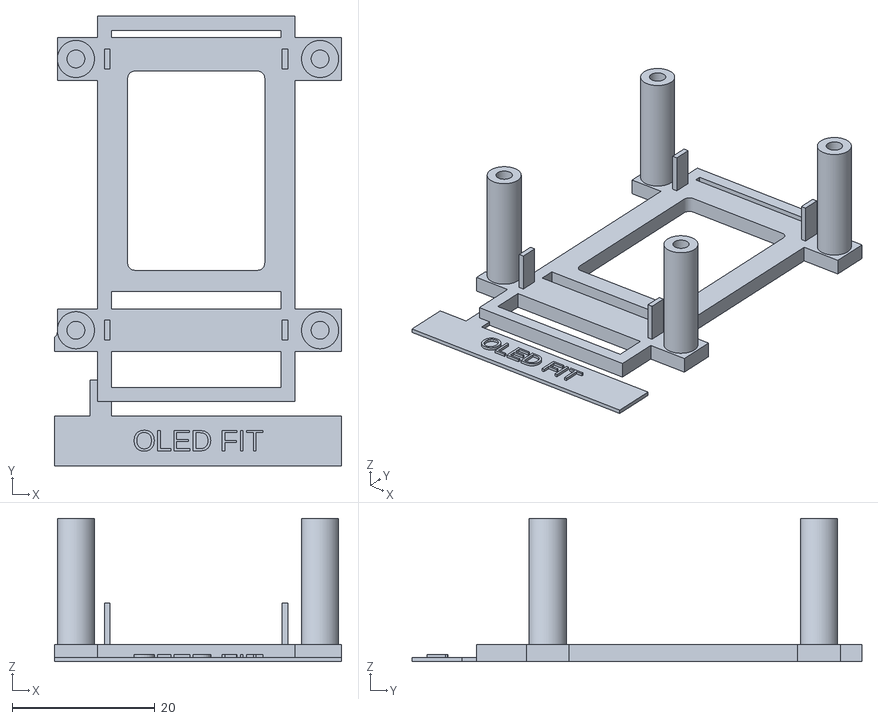
[picture p40: CAD file, 2026-10-23]
hardware/enclosure/fit-coupons/lightweight/labeled/heltec_screen.stl
40.2 x 63.0 x 20.1
