sintak15/s3-lora-interface/hardware/enclosure/sensors-front.stl

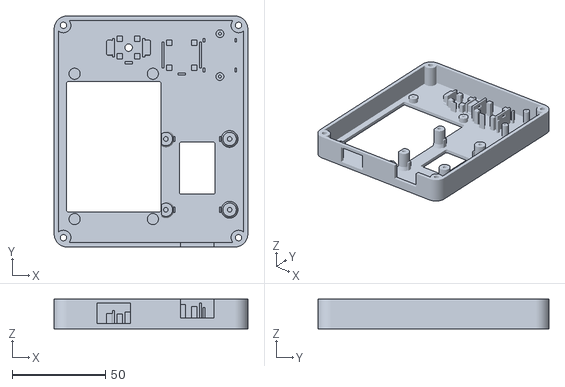
[picture p41: CAD file, 2026-11-07]
hardware/enclosure/sensors-front.stl
104.0 x 124.0 x 16.0
