sintak15/s3-lora-interface/hardware/enclosure/fit-coupons/labeled/cyd_usb.stl

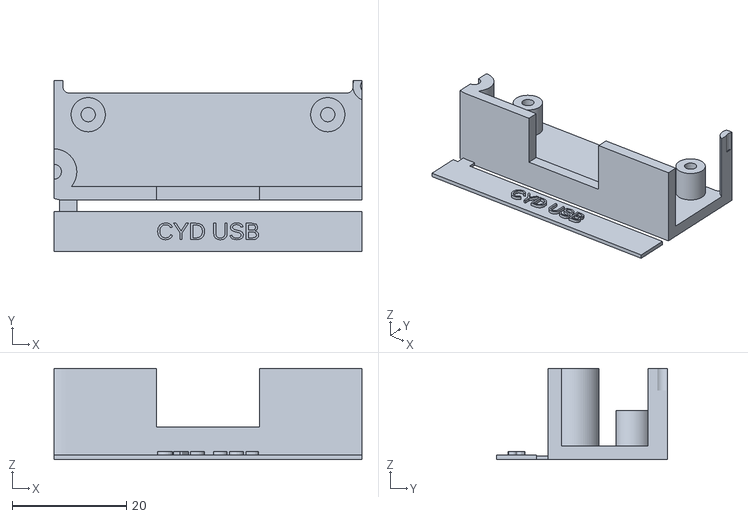
[picture p42: CAD file, 2026-10-23]
hardware/enclosure/fit-coupons/labeled/cyd_usb.stl
54.0 x 30.0 x 16.0
