sintak15/s3-lora-interface/hardware/enclosure/sensors-retrofit_antenna.stl

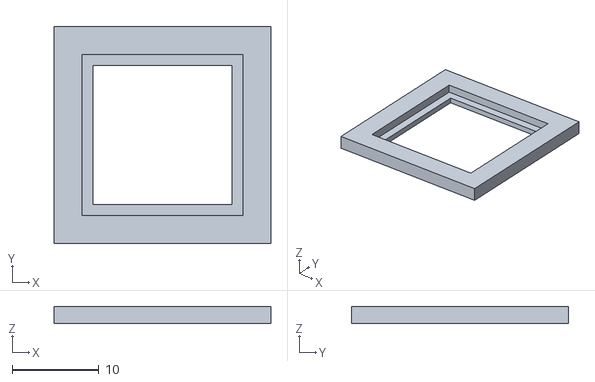
[picture p43: CAD file, 2026-11-07]
hardware/enclosure/sensors-retrofit_antenna.stl
25.0 x 25.0 x 2.00
