sintak15/s3-lora-interface/enclosure-v4-cyd-tight-test.stl

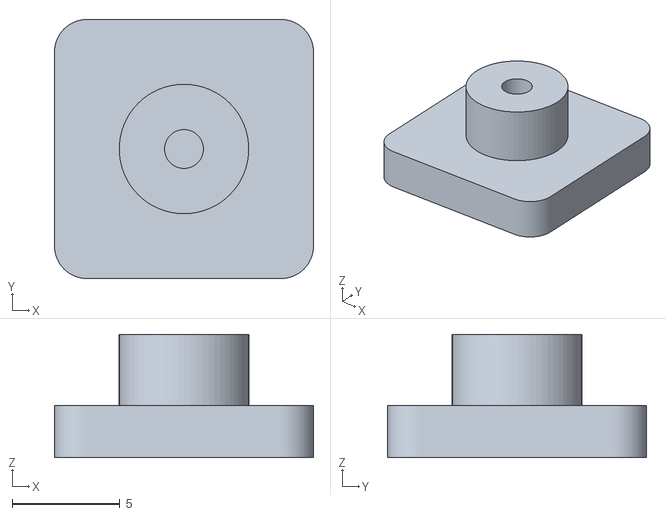
[picture p44: CAD file, 2026-10-23]
enclosure-v4-cyd-tight-test.stl
12.0 x 12.0 x 5.70
