sintak15/s3-lora-interface/hardware/enclosure/sensors-fit_coupon.stl

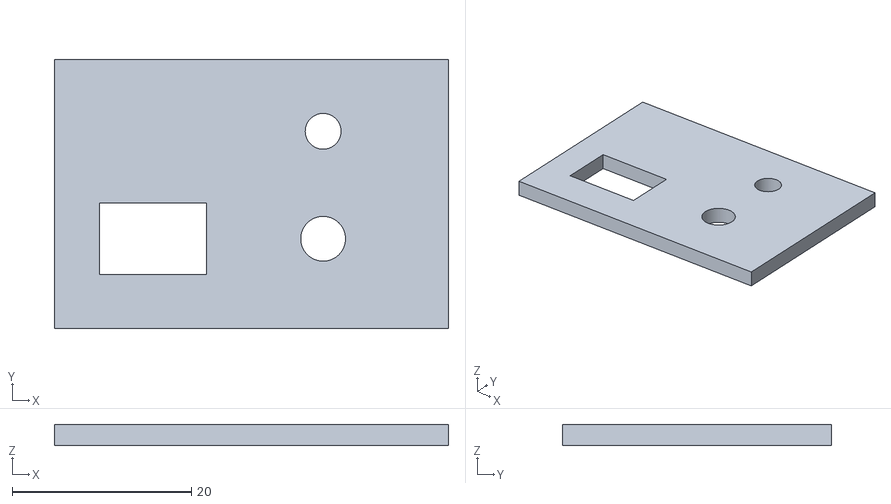
[picture p46: CAD file, 2026-11-07]
hardware/enclosure/sensors-fit_coupon.stl
44.0 x 30.0 x 2.40
