sintak15/s3-lora-interface/hardware/enclosure/sensors-am2302_holder.stl

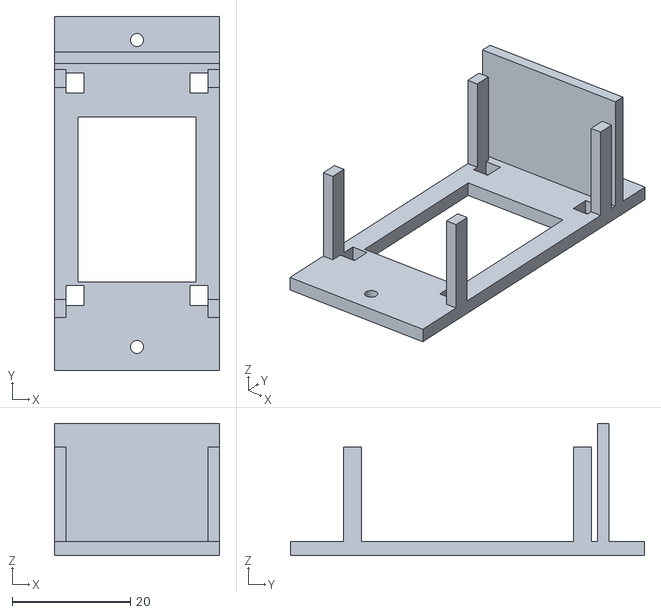
[picture p47: CAD file, 2026-11-07]
hardware/enclosure/sensors-am2302_holder.stl
28.0 x 60.0 x 22.4
