sintak15/s3-lora-interface/hardware/enclosure/sensors-keyboard_tray.stl

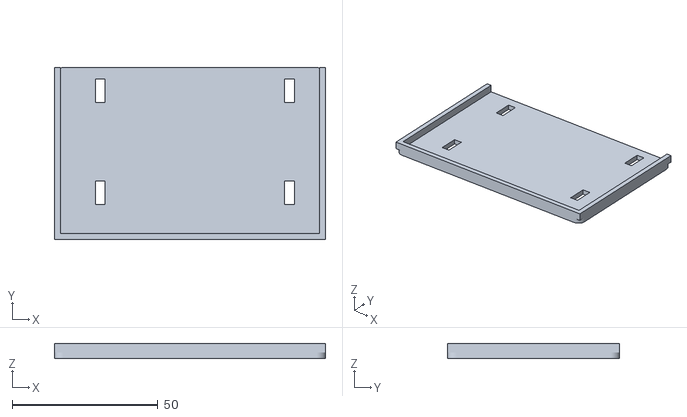
[picture p48: CAD file, 2026-11-07]
hardware/enclosure/sensors-keyboard_tray.stl
93.0 x 59.0 x 5.00
