sintak15/s3-lora-interface/hardware/enclosure/enclosure-v4-front-heavy-ties.stl

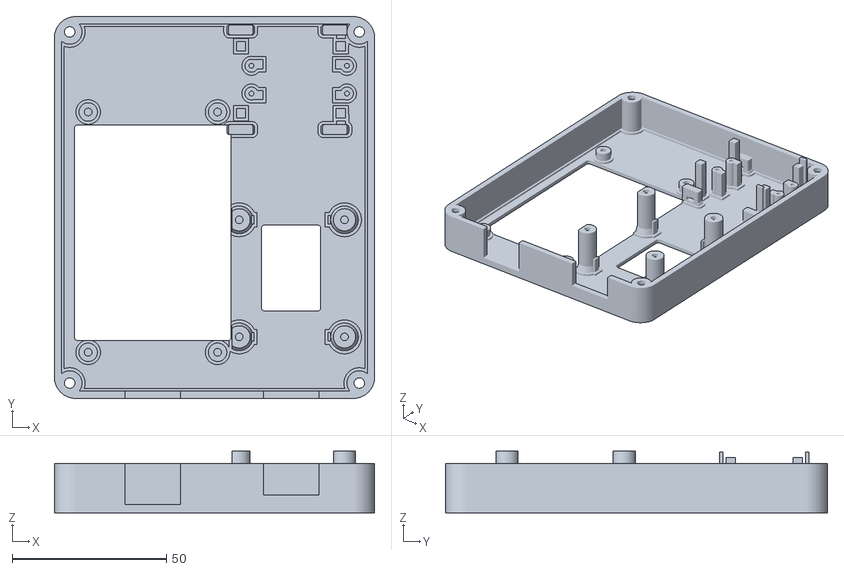
[picture p49: CAD file, 2026-10-23]
hardware/enclosure/enclosure-v4-front-heavy-ties.stl
104.0 x 124.0 x 20.1
