sintak15/s3-lora-interface/hardware/enclosure/enclosure-v4-fit-rear.stl

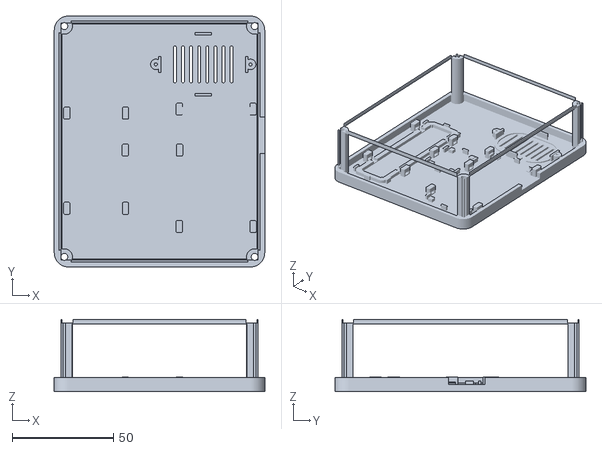
[picture p51: CAD file, 2026-10-23]
hardware/enclosure/enclosure-v4-fit-rear.stl
104.0 x 124.0 x 35.8
