sintak15/s3-lora-interface/hardware/enclosure/enclosure-v4-antenna-rails-repair.stl

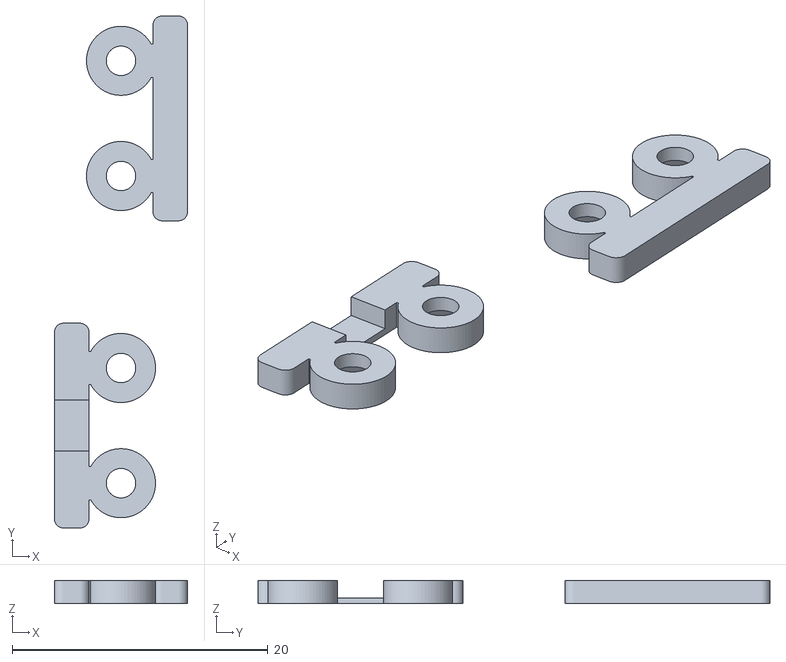
[picture p52: CAD file, 2026-10-23]
hardware/enclosure/enclosure-v4-antenna-rails-repair.stl
10.4 x 40.0 x 1.80
