sintak15/s3-lora-interface/hardware/enclosure/enclosure-v4-gps-rails.stl

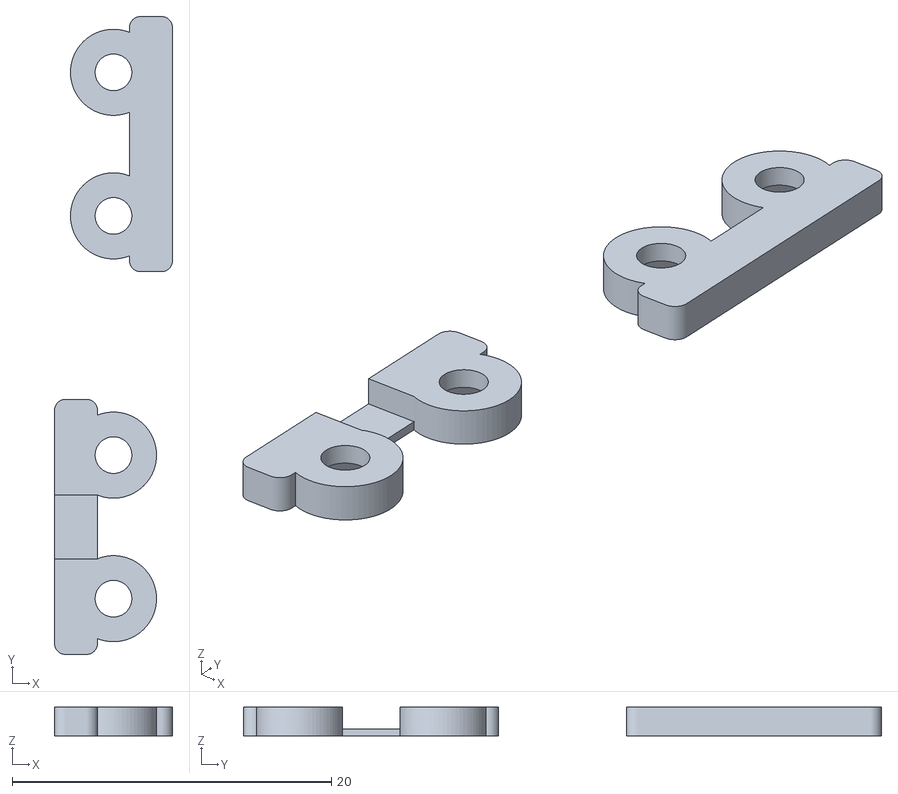
[picture p53: CAD file, 2026-10-23]
hardware/enclosure/enclosure-v4-gps-rails.stl
7.40 x 40.0 x 1.80
