sintak15/s3-lora-interface/hardware/enclosure/enclosure-v4-latest-base-and-heltec-brackets.stl

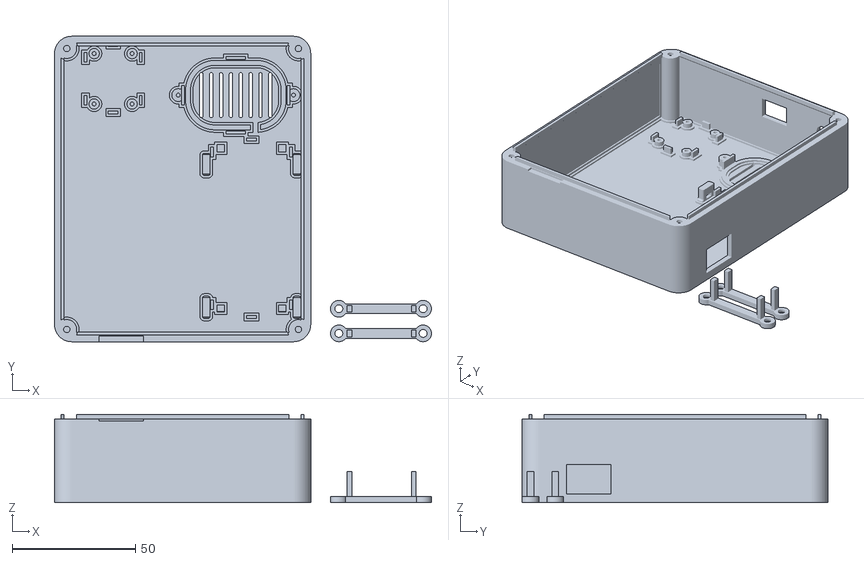
[picture p54: CAD file, 2026-10-23]
hardware/enclosure/enclosure-v4-latest-base-and-heltec-brackets.stl
153.0 x 124.0 x 35.8
