sintak15/s3-lora-interface/hardware/enclosure/enclosure-v4-heltec-clamps.stl

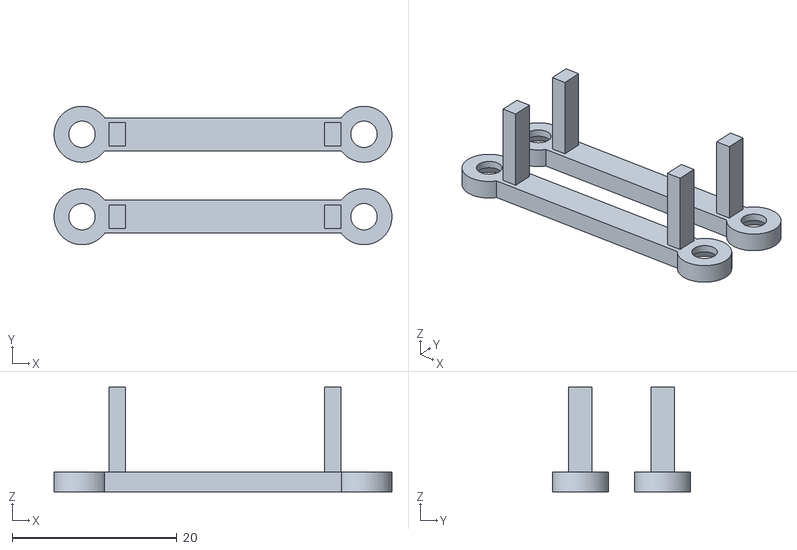
[picture p55: CAD file, 2026-10-23]
hardware/enclosure/enclosure-v4-heltec-clamps.stl
41.0 x 16.8 x 12.7
