sintak15/s3-lora-interface/hardware/enclosure/enclosure-v4-speaker-frame.stl

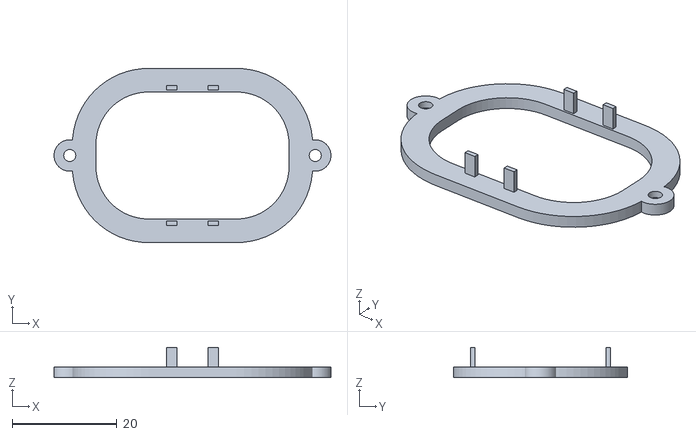
[picture p56: CAD file, 2026-10-23]
hardware/enclosure/enclosure-v4-speaker-frame.stl
52.8 x 33.2 x 5.80
