sintak15/s3-lora-interface/hardware/enclosure/enclosure-v4-all-parts-180mm.stl

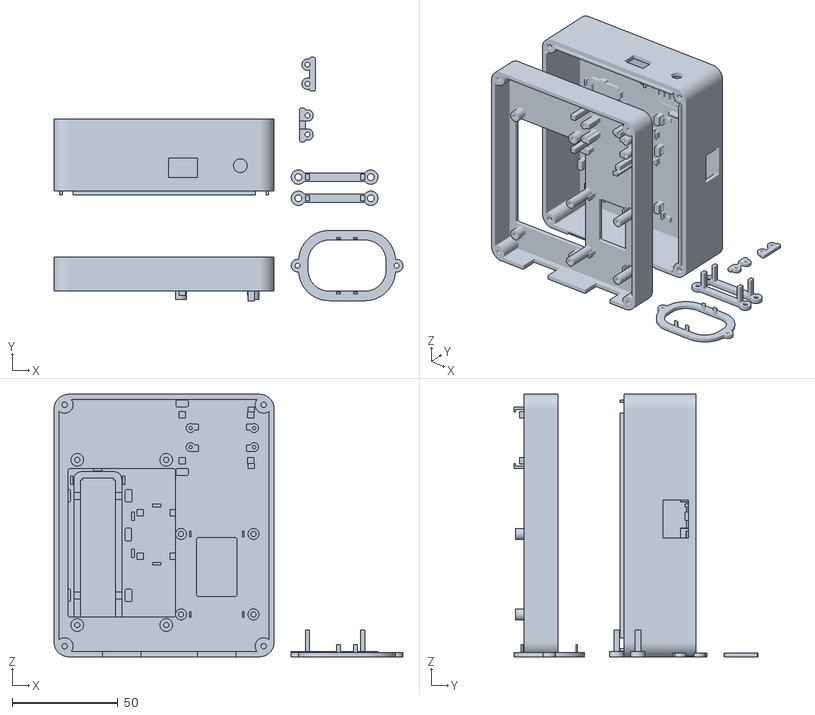
[picture p57: CAD file, 2026-10-23]
hardware/enclosure/enclosure-v4-all-parts-180mm.stl
164.8 x 115.0 x 124.0
