sintak15/s3-lora-interface/hardware/enclosure/enclosure-v4-gps-solid-rims-coupon.stl

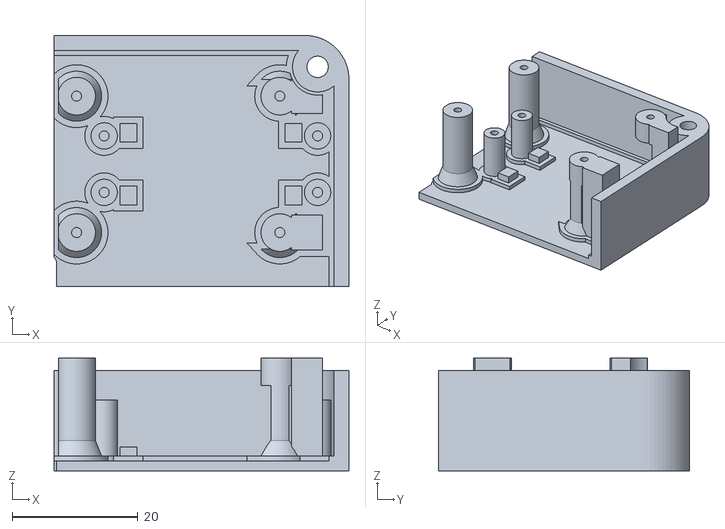
[picture p59: CAD file, 2026-10-23]
hardware/enclosure/enclosure-v4-gps-solid-rims-coupon.stl
47.0 x 40.0 x 18.0
