sintak15/s3-lora-interface/hardware/enclosure/enclosure-v4-fit-front.stl

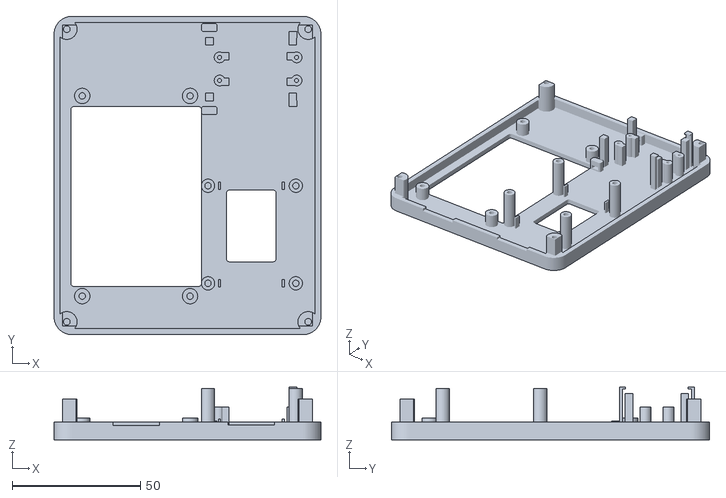
[picture p60: CAD file, 2026-10-23]
hardware/enclosure/enclosure-v4-fit-front.stl
104.0 x 124.0 x 20.6
