sintak15/s3-lora-interface/hardware/enclosure/enclosure-v4-base-cyd-3p3mm.stl

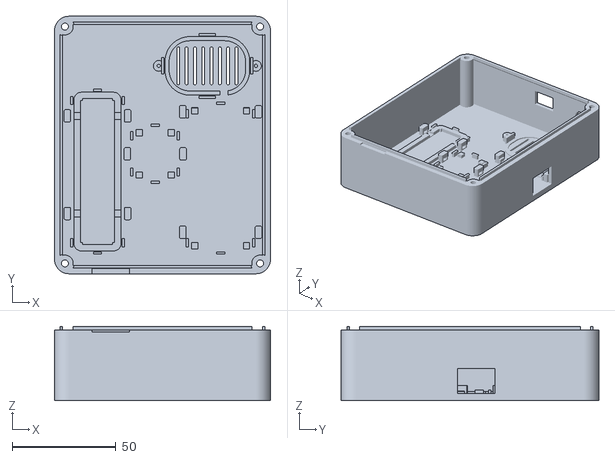
[picture p61: CAD file, 2026-10-23]
hardware/enclosure/enclosure-v4-base-cyd-3p3mm.stl
104.0 x 124.0 x 35.8
