sintak15/s3-lora-interface/hardware/enclosure/enclosure_v4_front_gps_pins_down.scad

/* Right means +X looking into the face with exterior against the bed.
   Shift antenna, posts and ledges together 2.5 mm right; PCB seats stay put.
   Pin positions/projection must be verified against the actual receiver.
*/
patch_lateral_shift = 2.5;
include <enclosure_v4_front_gps_repair.scad>
