sintak15/s3-lora-interface/hardware/enclosure/enclosure_v4_gps_pins_down_coupon.scad

translate([-57,-84,0]) intersection() {
    import("enclosure-v4-front-gps-pins-down.stl",convexity=10);
    translate([57,84,-0.01]) cube([47,40,50]);
}
