sintak15/s3-lora-interface/enclosure_v4_antenna_rails_repair.scad

coupon_mode = true;
patch_extra_clearance = 2;
patch_ledge_extra = 0.5;
patch_height_includes_pcb = true;
include <enclosure_v4.scad>
antenna_retainers_print();
