sintak15/s3-lora-interface/enclosure_v4_base_face_screws.scad

/* Faster matching base with screws inserted through the FRONT FACE.
   Four 8 mm corner posts have 2.6 mm pilots, 12 mm deep from the seam.
   Rear skin has no case-screw holes or head recesses.
   Existing printed face: drill the four case pilots to 3.2--3.4 mm clearance.
   Use M3 x 25 mm pan-head screws through the 16 mm front half.
*/
face_entry_case_screws = true;
include <enclosure_v4_base_fast.scad>
