sintak15/s3-lora-interface/enclosure_v4_base_max_screws.scad

/* Current reinforced open-battery base with four MAX M2 screw posts.
   Original support centres and 4.4 mm seating height retained.
   1.6 mm pilots, 3.2 mm deep; M2 x 4 mm pan-head screws for 1.6 mm PCB.
*/
max_screw_mounts = true;
include <enclosure_v4_base_heavy_ties.scad>
