sintak15/s3-lora-interface/enclosure_v4_front_neo6m_screws.scad

/* Latest reinforced face, Heltec posts lowered 5.2 mm, NEO-6M screw mounts.
   Existing GPS support centres and Z=18 PCB seating plane are retained.
   Four M2 x 6 mm pan-head screws, 1.6 mm pilot diameter, 6 mm blind depth.
*/
gps_screw_mounts = true;
include <enclosure_v4_front_posts_lower52.scad>
