sintak15/s3-lora-interface/hardware/enclosure/enclosure_v4_base_heavy_ties.scad

/* Current open-battery, bottom-USB, face-screw base with reinforced ties. */
heavy_tie_anchors = true;
include <enclosure_v4_base_power_usb_bottom.scad>
