sintak15/s3-lora-interface/hardware/enclosure/enclosure_v4_base_open_battery.scad

/* Open 48 x 80 mm battery-holder tape area in the lighter base.
   No cradle, fences or tie anchors in that area. MAX moves to antenna end.
   Holders up to 20.9 mm tall, allowing 1 mm tape, checked against face parts.
   Face-entry screws: M3 x 25, 2.6 mm pilots, 12 mm blind depth.
*/
open_battery_bay = true;
include <enclosure_v4_base_face_screws.scad>
