sintak15/s3-lora-interface/hardware/enclosure/enclosure_v4_base_power_usb_bottom.scad

/* Open battery base with charging USB on the bottom-wall end of the
   same side wall. End offset remains the existing 16 mm estimate.
   Power strap positions mirror along its 70 mm length with the assembly.
*/
power_usb_at_bottom = true;
include <enclosure_v4_base_open_battery.scad>
