sintak15/s3-lora-interface/hardware/enclosure/enclosure_v4_cyd_tight_coupon.scad

/* Test the tighter 1.8 mm pilot with actual screws before a full print. */
cyd_tight_pilot_d = 1.8;
include <enclosure_v4_cyd_m25_coupon.scad>
