sintak15/s3-lora-interface/hardware/enclosure/enclosure_v4_front_antenna_ledges_lower.scad

/* Keep the antenna bracket screw posts at 11.3 mm. Lower only the square
   bearing ledges to 3.8 mm, allowing the FULL 7.5 mm antenna below brackets.
   Retains the latest right-shifted antenna and pins-down receiver layout.
*/
patch_ledge_drop = 7.5;
antenna_flat_stack = true;
include <enclosure_v4_front_gps_pins_down.scad>
