sintak15/s3-lora-interface/hardware/enclosure/enclosure_v4_front_gps_repair.scad

/* Photo-fit revision: restored Heltec bracket posts, stronger GPS board
   towers and enlarged antenna space. Reprint matching antenna rails. */
heavy_tie_anchors = true;
heavy_heltec_posts = true;
face_entry_case_screws = true;
gps_screw_mounts = true;
gps_robust_mounts = true;
patch_height_includes_pcb = true;
patch_extra_clearance = 2;
patch_ledge_extra = 0.5;
include <enclosure_v4_front_cyd33.scad>
