sintak15/s3-lora-interface/hardware/enclosure/enclosure_v4_front_gps_solid_rims.scad

/* Fill the marked receiver-post rim recesses. Retain antenna + feed relief
   through 13.6 mm, then full solid post caps around the screw pilots.
   Local slicer supports may be needed under the newly filled caps.
*/
gps_solid_screw_rims = true;
include <enclosure_v4_front_antenna_ledges_lower.scad>
