sintak15/s3-lora-interface/hardware/enclosure/enclosure_v4_front_gps_tapered_rims.scad

/* 45-degree transitions below blue-marked GPS screw-post caps.
   Tighter 1.8 mm CYD pilots; all latest antenna/receiver positions retained.
*/
gps_taper_screw_rims = true;
cyd_tight_pilot_d = 1.8;
include <enclosure_v4_front_cyd_m25.scad>
