sintak15/s3-lora-interface/hardware/enclosure/enclosure_v4_front_heavy_ties.scad

/* Measured 3.3 mm CYD-post face with reinforced GPS receiver strap anchors. */
heavy_tie_anchors = true;
heavy_heltec_posts = true;
face_entry_case_screws = true;
patch_extra_clearance = 0.5;
include <enclosure_v4_front_cyd33.scad>
