sintak15/s3-lora-interface/hardware/enclosure/enclosure_v4_front_posts_lower52.scad

/* Lower ONLY the four Heltec bracket screw posts by 5.2 mm.
   Top plane 20.1 -> 14.9 mm from exterior. PCB seats stay at 8.2 mm.
   Brackets are not modified by this face-only export. Check their pin and
   PCB clearance when fitted lower; do not force them against components.
*/
heltec_post_drop = 5.2;
include <enclosure_v4_front_heavy_ties.scad>
