sintak15/s3-lora-interface/hardware/enclosure/fit-coupons/lightweight/labeled/battery.scad

union() {
 import("../battery.stl", convexity=10);
 translate([0,-9,0]) cube([26.599998474121094,7,0.6]);
 translate([1,-2.1,0]) cube([3,5.1,0.6]);
 translate([13.299999237060547,-5.5,0.5]) linear_extrude(0.5)
 text("BATTERY",size=3,font="Liberation Sans",halign="center",valign="center");
}
