sintak15/s3-lora-interface/hardware/enclosure/fit-coupons/lightweight/labeled/cyd_usb.scad

union() {
 import("../cyd_usb.stl", convexity=10);
 translate([0,-9,0]) cube([54.0,7,0.6]);
 translate([1,-2.1,0]) cube([3,5.1,0.6]);
 translate([27.0,-5.5,0.5]) linear_extrude(0.5)
 text("CYD USB",size=3,font="Liberation Sans",halign="center",valign="center");
}
