sintak15/s3-lora-interface/(list of files, cad)

Other CAD files:
enclosure-v4-front-antenna-ledges-lower.stl
hardware/enclosure/fit-coupons/labeled/heltec_clamp.stl
enclosure-v4-front-fast-no-supports.stl
enclosure-v4-front-cyd-m25.stl
hardware/enclosure/enclosure-v4-cyd-m25-test.stl
hardware/enclosure/enclosure-v4-front-gps-pins-down.stl
hardware/enclosure/enclosure-v4-gps-rails-clearance.stl
hardware/enclosure/enclosure-v4-base-heavy-ties.stl
hardware/enclosure/enclosure-v4-front-gps-repair.stl
hardware/enclosure/enclosure-v4-front-gps-tapered-rims.stl
hardware/enclosure/enclosure-v4-front-cyd-3p3mm.stl
hardware/enclosure/enclosure-v4-base-power-usb-bottom.stl
hardware/enclosure/enclosure-v4-front-gps-solid-rims.stl
hardware/enclosure/enclosure-v4-gps-tapered-rims-coupon.stl
hardware/enclosure/enclosure-v4-gps-repair-coupon.stl
enclosure_v4_antenna_ledges_coupon.scad
enclosure_v4_gps_tapered_rims_coupon.scad
hardware/enclosure/enclosure_v4_gps_solid_rims_coupon.scad
fit-coupons/lightweight/labeled/heltec_clamp.scad
hardware/enclosure/fit-coupons/lightweight/labeled/heltec.scad
hardware/enclosure/fit-coupons/lightweight/labeled/power.scad
enclosure-v4-base-face-screws.stl
fit-coupons/battery.stl
fit-coupons/heltec_clamp.stl
fit-coupons/labeled/battery.scad
fit-coupons/labeled/cyd_mounts.scad
fit-coupons/labeled/cyd_usb.scad
fit-coupons/labeled/heltec.scad
fit-coupons/lightweight/labeled/cyd_usb.stl
fit-coupons/lightweight/labeled/heltec.stl
fit-coupons/lightweight/labeled/max.scad
fit-coupons/lightweight/labeled/max.stl
fit-coupons/max.stl
hardware/enclosure/enclosure-v4-base-max-screw-posts.stl
hardware/enclosure/enclosure-v4-front-neo6m-screw-posts.stl
hardware/enclosure/enclosure_v2.scad
