sintak15/s3-lora-interface/docs/images/enclosure-v3-assembled.png

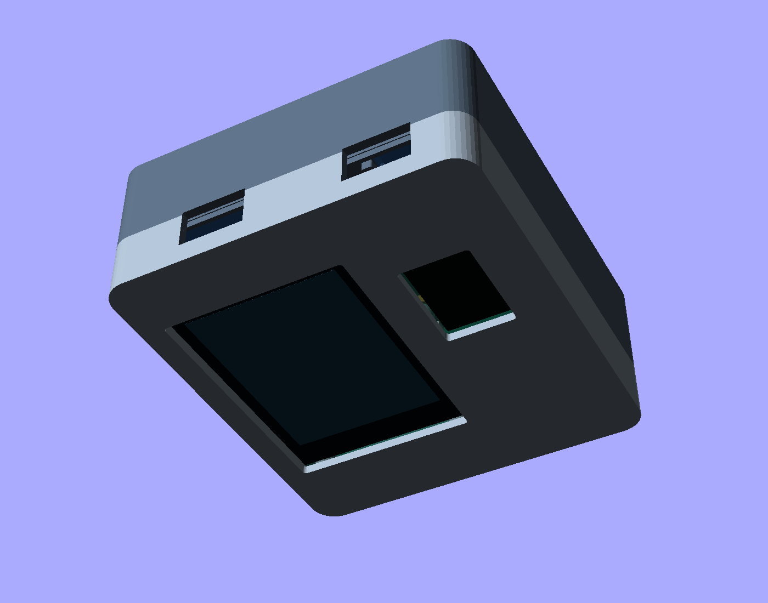
docs/images/enclosure-v3-assembled.png
