sintak15/s3-lora-interface/hardware/enclosure/sensors-assembled.png

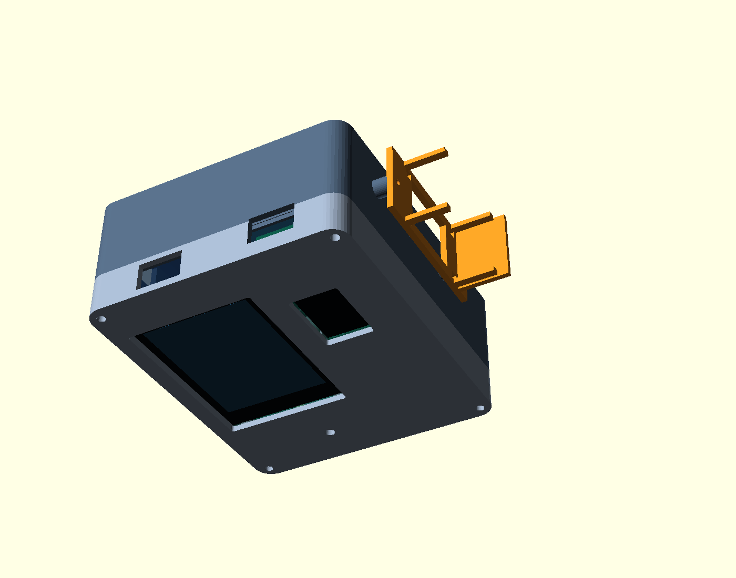
hardware/enclosure/sensors-assembled.png
