sintak15/s3-lora-interface/constants.h

#pragma once

#if __has_include("config/device_config.local.h")
#include "config/device_config.local.h"
#else
#include "config/device_config.example.h"
#endif

#define FIRMWARE_VERSION "v0.1.112"

#ifndef DEVICE_NAME
#define DEVICE_NAME "s3-lora-interface"
#endif

#ifndef DEVICE_HOSTNAME
#define DEVICE_HOSTNAME DEVICE_NAME
#endif

// UART connection from this ESP32-S3 interface board to the Heltec LoRa unit.
// Cross TX/RX between boards: interface TX -> Heltec RX, interface RX -> Heltec TX.
// Verified Heltec config: interface GPIO21 TX -> GPIO38 RX; interface GPIO14 RX <- GPIO39 TX.
#define LORA_RX_PIN 14
#define LORA_TX_PIN 21
#define LORA_UART_NUM 2
#define LORA_BAUD 115200

// GPS TX -> CYD GPIO3; CYD GPIO2 -> GPS RX.
// The Heltec receives CYD positions through the radio UART, with no direct GPS wire.
#define GPS_RX_PIN 3
// ATGM336H receive-only NMEA. Set to 1 only with a legacy u-blox receiver.
#ifndef GPS_RECEIVER_UBLOX
#define GPS_RECEIVER_UBLOX 0
#endif
// Explicit RX pin plus TX=-1 creates an RX-only UART in the pinned core.
#if GPS_RECEIVER_UBLOX
#define GPS_TX_PIN 2
#else
#define GPS_TX_PIN -1
#endif
#define GPS_BAUD 9600

// 2.8 inch ESP32-S3 ILI9341 display and capacitive touch.
#define SCREEN_W 240
#define SCREEN_H 320
#define TFT_BL 45
#define TOUCH_ADDR 0x38
#define TOUCH_RST 18
#define TOUCH_INT 17
#define TOUCH_SDA 16
#define TOUCH_SCL 15

// LCDWiki ESP32-S3 CYD speaker port. The audio enable line is active-low.
#ifndef CYD_AUDIO_ENABLE_PIN
#define CYD_AUDIO_ENABLE_PIN 1
#endif

#ifndef CYD_AUDIO_ENABLE_LEVEL
#define CYD_AUDIO_ENABLE_LEVEL LOW
#endif

#ifndef CYD_AUDIO_MCLK_PIN
#define CYD_AUDIO_MCLK_PIN 4
#endif

#ifndef CYD_AUDIO_BCLK_PIN
#define CYD_AUDIO_BCLK_PIN 5
#endif

#ifndef CYD_AUDIO_DOUT_PIN
#define CYD_AUDIO_DOUT_PIN 8
#endif

#ifndef CYD_AUDIO_LRCLK_PIN
#define CYD_AUDIO_LRCLK_PIN 7
#endif

#ifndef CYD_AUDIO_CODEC_ADDR
#define CYD_AUDIO_CODEC_ADDR 0x18
#endif

// External ADS1115 on the shared I2C bus; A0 senses a 10k/10k divider.
#ifndef BATTERY_ADS1115_ADDR
#define BATTERY_ADS1115_ADDR 0x48
#endif
#ifndef BATTERY_DIVIDER_TOP_OHMS
#define BATTERY_DIVIDER_TOP_OHMS 10000UL
#endif
#ifndef BATTERY_DIVIDER_BOTTOM_OHMS
#define BATTERY_DIVIDER_BOTTOM_OHMS 10000UL
#endif
#ifndef BATTERY_ADC_SCALE
#define BATTERY_ADC_SCALE 1.0f
#endif

// ADS1115 A1: boosted 5V through a separate 10k/10k divider.
#ifndef BOOST_DIVIDER_TOP_OHMS
#define BOOST_DIVIDER_TOP_OHMS 10000UL
#endif
#ifndef BOOST_DIVIDER_BOTTOM_OHMS
#define BOOST_DIVIDER_BOTTOM_OHMS 10000UL
#endif
#ifndef BOOST_ADC_SCALE
#define BOOST_ADC_SCALE 1.0f
#endif

// Built-in MicroSD socket on the LCDWiki 2.8" ESP32-S3 display.
// The socket uses the ESP32-S3 SDMMC/SDIO peripheral, not the TFT SPI bus.
#define SD_CLK_PIN 38
#define SD_CMD_PIN 40
#define SD_D0_PIN 39
#define SD_D1_PIN 41
#define SD_D2_PIN 48
#define SD_D3_PIN 47
#define SD_MMC_ONE_BIT false
#define SD_MMC_FREQ 20000

// Browser interface served by this board.
#ifndef INTERFACE_AP_SSID
#define INTERFACE_AP_SSID DEVICE_NAME
#endif

#ifndef INTERFACE_AP_PASS
#define INTERFACE_AP_PASS "setup1234"
#endif

#ifndef WIFI_AP_CHANNEL
#define WIFI_AP_CHANNEL 6
#endif

#ifndef WEBUI_AUTH_USER
#define WEBUI_AUTH_USER "admin"
#endif

#ifndef WEBUI_AUTH_PASS
#define WEBUI_AUTH_PASS "setup1234"
#endif

#ifndef FORCE_INTERFACE_SETTINGS
#define FORCE_INTERFACE_SETTINGS 0
#endif

// AM2302 reuses GPIO2 only with RX-only GPS. No UART0/USB header wiring.
#ifndef AM2302_DATA_PIN
#if GPS_RECEIVER_UBLOX
#define AM2302_DATA_PIN -1
#else
#define AM2302_DATA_PIN 2
#endif
#endif
