sintak15/s3-lora-interface/src/firmware/Declarations.h

#pragma once

// Internal interfaces shared by the firmware modules.
static fs::FS& sdCardFilesystem();
static bool sendTextMessage(const char* text, int8_t channelIndex = PUBLIC_CHANNEL_INDEX);
static bool sendDirectTextMessage(const char* text, uint32_t toNode);
static bool isDirectAddress(uint32_t to);
static void sendDirectFromInput(lv_obj_t* toInput, lv_obj_t* msgInput);
static const char* publicChannelLabel();
static const char* privateChannelLabel();
static void formatChannelPrompt(const char* channel, char* out, size_t outSize);
static void refreshChannelUiLabels();
static bool isPublicChannelName(const char* name);
static const char* nodeName(uint32_t num);
static NodeRecord* findOrCreateNode(uint32_t num);
static void allocateRuntimeBuffers();
static void appendLine(char* buffer, size_t bufferSize, const char* line);
static void appendPacketEvent(const char* line);
static void refreshDashboardLabels();
static void loadPowerLogView();
static void showNodeDetail(uint32_t nodeNum);
static void directSelectedNode();
static void showSelectedNodeOnMap();
static void cycleNodeSort();
static void cycleNodeFilter();
static void clearNodeList();
static bool sendHeltecNodeDbReset();
static bool sendHeltecFavoriteNode(uint32_t nodeNum, bool favorite);
static bool retryTx(uint32_t packetId);
static bool retryLastTx();
static const char* txErrorText(const TxRecord& record);
static void printFirmwareIdentity();
static String buildFieldReportJson();
static void refreshNodeDetailFavoriteButton();
static void refreshTxHistoryView();
static void refreshNodeList(bool force = false);
static void refreshMessageDiagView();
static void refreshMapUi();
static double distanceMeters(double lat1, double lon1, double lat2, double lon2);
static void loadMapCacheFromSd();
static void printSdTileSummary();
static void printSdTileFastSummary();
static void refreshChatViews(bool force = false);
static void setReadableTextMode(bool enabled, bool save);
static void initToneAudio();
static void serviceToneAudio();
static void queueTone(ToneKind kind);
static void rebuildScreenUi(lv_obj_t* targetPage = nullptr);
static void styleDarkObject(lv_obj_t* obj, uint32_t bg, uint32_t text = COLOR_TEXT);
static void styleDarkBorder(lv_obj_t* obj, uint32_t color = COLOR_BORDER);
static void styleBoundedLabel(lv_obj_t* label, lv_coord_t width, uint32_t color = COLOR_TEXT, lv_label_long_mode_t mode = LV_LABEL_LONG_DOT);
static void setReadoutText(lv_obj_t* label, const char* text);
static void setReadoutArea(lv_obj_t* area, const char* text);
static void showPage(lv_obj_t* target, bool remember = true);
static void ensureWifiScanPage();
static void detectMapTileRoot(bool logResult = false);
static void printMapTileRootCandidates();
static void serviceOneTimeChannelProvision();
static bool usbTileUploadActive();
static void serviceUsbTileTimeout();
static bool handleUsbTileCommand(char* command);
static bool usbSdExportActive();
static void serviceUsbSdTimeout();
static bool handleUsbSdCommand(char* command);

static void markUiDirty(uint32_t flags);
static bool isUiDirty(uint32_t flags);
static void clearUiDirty(uint32_t flags);
static void* allocatePsramBuffer(size_t bytes, const char* name);
static void initSdMutex();
static bool lockSd(uint32_t timeoutMs = 2000);
static void unlockSd();
static UBaseType_t sdAppendQueueWaiting();
static void sdAppendTask(void*);
static void initSdAppendWorker();
static void initMapRenderWorker();
static size_t loadSdTextTail(const char* path, char* buffer, size_t bufferSize);
static bool chatLineLooksValid(const char* line);
static void sanitizeChatLog(char* buffer);
static void loadChatLogsFromSd();
static bool appendSdLine(const char* path, const char* line);
static void initSdStorage();
static void refreshSdUsage();
static void buildTileRootPath(const char* root, int zoom, char* path, size_t pathSize);
static void buildTilePath(const char* root, int zoom, long x, long y, char* path, size_t pathSize);
static uint8_t scoreMapTileRoot(const char* root);
static const char* pathBasename(const char* path);
static long parseTileNumber(const char* text);
static void inspectTileYRange(File& xDir, uint32_t* count, long* minY, long* maxY);
static void logPositionToSd(uint32_t from, const char* sourceKind, double lat, double lon, int32_t alt);
static void saveLastLocationToSd(double lat, double lon, int32_t alt);
static bool loadLastLocationFromSd();
static void updateLocalGpsStats();
static void pollLocalGps();
static void serviceGpsRelay();
static bool setGpsRelayEnabled(bool enabled);
static bool prepareGpsRelay();
static bool gpsRelaySetupBusy();
static const char* gpsRelaySetupError();
static GpsRelay::State gpsRelayState();
static void onGpsRelayConfig(bool position);
static void onGpsRelayConfigComplete(uint32_t id);
static void resetGpsRelayLink();
static unsigned long bytesToWholeKb(uint64_t bytes);
static unsigned long bytesToWholeMb(uint64_t bytes);
static unsigned long heapCapKb(uint32_t caps);
static unsigned long heapCapLargestKb(uint32_t caps);
static void recordMapRenderTimingDuration(uint32_t durationMs, bool drewTiles, bool cacheHit);
static void recordMapRenderTiming(uint32_t startedMs, bool drewTiles, bool cacheHit);
static const char* i2cKnownDeviceName(uint8_t addr);
static size_t scanI2cPair(uint8_t sda, uint8_t scl, char* out, size_t outSize);
static String buildI2cProbeJson();
static const char* batteryAlertLabel();
static void sampleLocalBattery();
static void copyPreferenceString(const char* key, char* dest, size_t destSize, const char* fallback);
static void loadInterfaceSettings();
static bool usingDefaultWebCredentials();
static bool setupRouteAllowed();
static void saveInterfaceSettings(const String& deviceName, const String& hostname, const String& apSsid, uint8_t apChannel, const String& user, const String& pass);
static void startWifiAp();
static void startWifiLocal();
static void startWifi();
static void stopWifi();
static void setWifiEnabled(bool enabled);
static void setWifiApMode(bool apMode);
static void saveWifiCredentials();
static void renderWifiScanResults(int16_t status);
static void renderStoredWifiScanResults(int16_t status);
static void wifiScanTask(void*);
static void requestWifiScan();
static void startWifiScan();
static void pollWifiScan();
static void applyBacklight();
static void initBacklight();
static void applyFontMode();
static void backlightSliderEvent(lv_event_t* e);
static ToneStyle clampToneStyle(uint8_t style);
static const char* toneStyleName(ToneStyle style);
static void setToneDropdownOptions(lv_obj_t* dropdown);
static ToneStyle toneStyleForKind(ToneKind kind);
static const ToneSegment* tonePatternFor(ToneStyle style, size_t& count);
static uint8_t toneCodecVolumeRegister();
static float toneCodecGainDb();
static bool toneCodecWrite(uint8_t reg, uint8_t value);
static void requestToneRecovery(bool manual);
static int toneCodecReadInt(uint8_t reg);
static bool initToneCodec();
static void toneSetSpeakerEnabled(bool enabled);
static void applyToneVolume();
static const char* toneAudioStateLabel();
static void updateToneVolumeLabel();
static void toneVolumeSliderEvent(lv_event_t* e);
static void updateToneDropdowns();
static void toneMessageDropdownEvent(lv_event_t* e);
static void toneDirectDropdownEvent(lv_event_t* e);
static bool queueToneStyle(ToneStyle style);
static int8_t toneStyleIndexFromText(String value);
static String buildToneStatusJson();
static void lvFlush(lv_disp_drv_t* disp, const lv_area_t* area, lv_color_t* colors);
static bool readTouch(uint16_t& x, uint16_t& y);
static void lvTouchRead(lv_indev_drv_t* indev, lv_indev_data_t* data);
static void styleDarkTextArea(lv_obj_t* ta);
static lv_obj_t* makePanel(lv_obj_t* parent);
static lv_obj_t* makePage(lv_obj_t* parent);
static void makePageScrollable(lv_obj_t* page);
static void buildStatusBar(lv_obj_t* screen);
static int activeMapPlotHeight();
static void setMapZoom(int zoom, bool save = true);
static void setMapFollow(bool enabled);
static void invalidateMapView();
static void mapDragEvent(lv_event_t* e);
static void serviceMapNavigationSettings();
static void updateMapControls();
static void updateMapScale();
static bool mapCoverageMatches(double lat, double lon, uint16_t height);
static MapCoverage::Profile probeMapCoverage(const MapRenderJob& job);
static void renderCoveredMap(MapRenderJob job, MapRenderResult& result);
static void updateMapCoverageUi();
#ifdef FIRMWARE_RUN_TESTS
static void runMapCoverageTests();
#endif
static bool mapDevicePosition(double& lat, double& lon, char* source, size_t sourceSize);
#ifdef FIRMWARE_RUN_TESTS
static void runMapNavigationTests();
#endif
static void clearUiObjectPointers();
static lv_obj_t* makeActionButton(lv_obj_t* parent, const char* text, int y, lv_event_cb_t cb);
static lv_obj_t* makeSmallButton(lv_obj_t* parent, const char* text, int x, int y, int w, lv_event_cb_t cb);
static lv_obj_t* makeSystemTile(lv_obj_t* parent, const char* text, int col, int row, lv_event_cb_t cb);
static lv_obj_t* makeDashboardLabel(lv_obj_t* parent, int x, int y, int w, int h);
static lv_obj_t* makePageTitle(lv_obj_t* parent, const char* text);
static lv_obj_t* makeNavButton(lv_obj_t* parent, const char* text, lv_align_t align, int x, lv_event_cb_t cb);
static void buildNavBar(lv_obj_t* screen);
static lv_obj_t* makeReadonlyText(lv_obj_t* parent, int y, int h);
static bool setReadonlyTextStable(lv_obj_t* ta, const char* text, bool scrollTop = false);
static void scrollReadonlyTextToBottom(lv_obj_t* ta);
static bool setReadonlyTextNewest(lv_obj_t* ta, const char* text, bool forceScroll = false);
static NodeRecord* findNode(uint32_t num);
static uint32_t nodeAgeSeconds(const NodeRecord& node, uint32_t nowMs);
static double headingTo(double lat1, double lon1, double lat2, double lon2);
static const char* nodeSortLabel();
static const char* nodeFilterLabel();
static const char* nodeListViewLabel();
static void formatShortAge(uint32_t ageSeconds, char* out, size_t outSize);
static bool nodeHasRange(const NodeRecord& node);
static double nodeRangeMeters(const NodeRecord& node);
static const char* nodeStatusLabel(const NodeRecord& node, uint32_t nowMs);
static uint32_t nodeRowBg(const NodeRecord& node, uint32_t nowMs);
static uint32_t nodeRowBorder(const NodeRecord& node, uint32_t nowMs);
static bool nodeMatchesFilter(const NodeRecord& node, uint32_t nowMs);
static bool nodeComesBefore(const NodeRecord& a, const NodeRecord& b, uint32_t nowMs);
static void formatRangeBearing(const NodeRecord& node, char* buffer, size_t bufferSize);
static void nodeListButtonEvent(lv_event_t* e);
static void cycleNodeListView();
static void toggleSelectedNodeFavorite();
static int8_t activeChatChannel();
static void sendFromInput(lv_obj_t* input, int8_t channelIndex);
static void sendActiveFromScreen();
static void setUiLandscape(bool landscape);
static void closeLandscapeKeyboard(bool send);
static void landscapeKeyboardEvent(lv_event_t* e);
static void openLandscapeKeyboard(lv_obj_t* input, const char* prompt, size_t maxLength, bool sendsMessage);
static void inputEvent(lv_event_t* e);
static void wifiInputEvent(lv_event_t* e);
static void deferWifiAction(uint8_t action);
static void ensureWifiLocalPage();
static void processDeferredWifiAction();
static void buildLandscapeKeyboardScreen();
static void buildScreenUi();
static void initScreen();
static size_t countPositionedNodes();
static bool updateNodePosition(uint32_t nodeNum, const meshtastic_Position& position, const char* source);
static long lonToTileX(double lon, int zoom);
static double lonToGlobalPixelX(double lon, int zoom);
static long latToTileY(double lat, int zoom);
static double latToGlobalPixelY(double lat, int zoom);
static bool mapTileExists(int zoom, long x, long y, char* path, size_t pathSize);
static int findBestMapZoom(double lat, double lon, char* centerPath, size_t centerPathSize);
static lv_color_t rgb565ToLvColor(uint16_t rgb565);
static void saveMapCacheToSd();
static bool mapRenderJobMatches(const MapRenderJob& job,
                                double lat,
                                double lon,
                                int zoom,
                                uint16_t plotH,
                                long centerTileX,
                                long centerTileY,
                                int centerPixelX,
                                int centerPixelY);
static bool mapCacheMatchesCenter(double lat,
                                  double lon,
                                  int zoom,
                                  uint16_t plotH,
                                  long* centerTileX = nullptr,
                                  long* centerTileY = nullptr,
                                  int* centerPixelX = nullptr,
                                  int* centerPixelY = nullptr);
static bool mapRenderHasPendingResult();
static bool assembleMapTilesToBuffer(const MapRenderJob& job, MapRenderResult& result, bool useTileCache = true);
static void requestMapBenchmark();
static void runMapBenchmark(const MapRenderJob& job, MapRenderResult& result);
static void mapRenderTask(void*);
static bool requestMapTileRender(double lat,
                                 double lon,
                                 int zoom,
                                 uint16_t plotH,
                                 long centerTileX,
                                 long centerTileY,
                                 int centerPixelX,
                                 int centerPixelY);
static void serviceMapRenderWorker();
static bool renderOfflineTileMap(double lat, double lon, int zoom, char* centerPath, size_t centerPathSize);
static bool placeMapDot(size_t index, double centerLat, double centerLon, double lat, double lon, int zoom, lv_color_t color, int size);
static const char* linkHealthText();
static uint32_t loraStatusColor();
static bool gpsSatsPresent();
static void formatPreviewLine(const char* name, uint16_t unread, const char* preview, char* out, size_t outSize);
static void refreshScreenUi();
static uint32_t parseNodeAddress(const char* text);
static void serviceScreen();
static void printSerialDiagnostics();
static void serviceUsbSerialCommands();
static const char* channelName(uint8_t index);
static void formatNoChannelChat(const char* channel, char* out, size_t outSize);
static ChannelRecord* channelRecordByIndex(uint8_t index);
static bool hasEnabledChannelRecords();
static void refreshPrivateChannelIndex();
static void updateChannelRecord(const meshtastic_Channel& channel);
static const char* loraRegionName(meshtastic_Config_LoRaConfig_RegionCode value);
static const char* loraPresetName(meshtastic_Config_LoRaConfig_ModemPreset value);
static const char* deviceRoleName(meshtastic_Config_DeviceConfig_Role value);
static const char* rebroadcastName(meshtastic_Config_DeviceConfig_RebroadcastMode value);
static const char* buzzerName(meshtastic_Config_DeviceConfig_BuzzerMode value);
static const char* gpsModeName(meshtastic_Config_PositionConfig_GpsMode value);
static const char* serialBaudName(meshtastic_ModuleConfig_SerialConfig_Serial_Baud value);
static const char* serialModeName(meshtastic_ModuleConfig_SerialConfig_Serial_Mode value);
static void cacheHeltecConfig(const meshtastic_Config& config);
static void cacheHeltecModuleConfig(const meshtastic_ModuleConfig& moduleConfig);
static bool isPrivateChannel(uint8_t index);
static TxRecord* latestTxRecord();
static void describeTxDestination(const TxRecord& record, char* out, size_t outSize);
static void recordTxMessage(uint8_t channel, uint32_t to, const char* text, size_t len, bool ok, uint32_t packetId);
static void markTxEchoSeen(uint8_t channel, uint32_t to, const uint8_t* text, size_t len);
static const char* txStatusText(const TxRecord& record, uint32_t nowMs);
static void formatNodeLabel(const NodeRecord& node, char* out, size_t outSize);
static int messageDiagIndexForNode(uint32_t nodeNum);
static uint32_t messageDiagNodeForSelection(lv_obj_t* dropdown);
static TxRecord* findMessageDiagTxRecord();
static const char* messageDiagEchoLabel(const TxRecord* record, uint32_t nowMs);
static void formatMessageDiagReadout(char* out, size_t outSize);
static void syncMessageDiagTargetsFromDropdowns();
static bool sendMessageDiagTo(uint32_t nodeNum, const char* targetName);
static void messageDiagDropdownEvent(lv_event_t* e);
static void messageDiagSendAEvent(lv_event_t*);
static void messageDiagSendBEvent(lv_event_t*);
static void messageDiagSwapEvent(lv_event_t*);
static void rememberLocalSentText(uint8_t channel, uint32_t to, const char* text, size_t len);
static bool isRecentLocalEcho(uint8_t channel, uint32_t to, const uint8_t* text, size_t len);
static void formatChatTimestamp(char* out, size_t outSize);
static void copyChatPreview(char* out, size_t outSize, const char* sender, const uint8_t* text, size_t len);
static void recordChatActivity(uint8_t channel, uint32_t to, const char* sender, const uint8_t* text, size_t len);
static void appendChatMessage(uint8_t channel, uint32_t to, const char* sender, const uint8_t* text, size_t len, bool local, uint32_t from = 0);
static bool writeStreamFrame(const uint8_t* payload, size_t len);
static uint32_t allocateMeshPacketId();
static uint8_t activeHopLimit();
static void applyClientPacketDefaults(meshtastic_MeshPacket& packet);
static bool sendConfigRequest();
static bool sendRadioHeartbeat();
static void serviceRadioApiKeepalive();
static void serviceConfigRequests();
static bool sendLocalAdmin(const meshtastic_AdminMessage& admin);
static bool sendHeltecReboot(uint8_t seconds);
static meshtastic_Config_LoRaConfig_RegionCode parseRegion(const String& value);
static meshtastic_Config_LoRaConfig_ModemPreset parseModemPreset(const String& value);
static meshtastic_Channel_Role parseChannelRole(const String& value);
static meshtastic_ModuleConfig_SerialConfig_Serial_Baud parseSerialBaud(const String& value);
static meshtastic_ModuleConfig_SerialConfig_Serial_Mode parseSerialMode(const String& value);
static meshtastic_Config_DeviceConfig_Role parseDeviceRole(const String& value);
static meshtastic_Config_DeviceConfig_RebroadcastMode parseRebroadcastMode(const String& value);
static meshtastic_Config_DeviceConfig_BuzzerMode parseBuzzerMode(const String& value);
static meshtastic_Config_PositionConfig_GpsMode parseGpsMode(const String& value);
static bool formBool(const char* name);
static uint32_t formU32(const char* name, uint32_t fallback = 0);
static int32_t formI32(const char* name, int32_t fallback = 0);
static uint8_t formU8(const char* name, uint8_t fallback = 0);
static void formStr(const char* name, char* dest, size_t destSize, bool keepBlank = false);
static bool sendHeltecLoraConfig(const String& region, const String& preset, uint8_t hopLimit, int8_t txPower);
static bool sendHeltecSerialConfig(bool enabled, uint32_t rxd, uint32_t txd, const String& baud, const String& mode, uint32_t timeoutMs, bool echo, bool overrideConsole);
static bool sendHeltecOwnerName(const String& name, const String& shortName);
static bool sendHeltecDeviceConfig(const String& role, const String& rebroadcast, uint32_t nodeInfoSecs, const String& tz, bool ledOff, const String& buzzer);
static bool sendHeltecPositionConfig(bool gpsEnabled, const String& gpsMode, bool fixedPosition, bool smartBroadcast, uint32_t broadcastSecs, uint32_t gpsUpdateSecs, uint32_t gpsAttemptSecs, uint32_t smartMinMeters, uint32_t smartMinSecs);
static bool sendHeltecPowerConfig(bool powerSaving, uint32_t shutdownSecs, uint32_t waitBluetoothSecs, uint32_t sdsSecs, uint32_t lsSecs, uint32_t minWakeSecs);
static bool sendHeltecNetworkConfig();
static bool sendHeltecDisplayConfig();
static bool sendHeltecBluetoothConfig();
static bool sendHeltecModuleConfig(const String& section);
static bool sendHeltecTimezone(const String& tz);
static bool sendHeltecCommit();
static int8_t hexNibble(char c);
static bool isValidPskByteSize(size_t len);
static bool copyStoredChannelPsk(uint8_t index, meshtastic_ChannelSettings_psk_t& dest);
static bool parseChannelPsk(const String& value, meshtastic_ChannelSettings_psk_t& dest);
static bool sendHeltecChannelConfig(uint8_t index, const String& role, const String& name, const String& psk, bool uplink, bool downlink, int32_t positionPrecision);
static bool sendChannelProvisionStep(uint8_t step);
static void updateTelemetry(uint32_t from, const meshtastic_Data& data);
static void handleDecodedPacket(const meshtastic_MeshPacket& packet);
static void decodeFromRadio(const uint8_t* payload, size_t len);
static void pollLoRa();
static String jsonEscape(const char* text);
static void appendBatteryStatusJson(String& json);
static void appendSdStatusJson(String& json);
static void appendChatStatusJson(String& json);
static void appendLinkStatusJson(String& json, const char* rxAge);
static void appendInterfaceStatusJson(String& json, const String& wifiIp, const esp_partition_t* runningPartition);
static void appendMapStatusJson(String& json);
static void appendHeltecConfigStatusJson(String& json);
static void appendChannelsStatusJson(String& json);
static void appendNodesStatusJson(String& json);
static bool requireWebAuth();
static String buildStatusJson();
static void handleStatus();
static void handleStatusSnapshot();
static void finishSdDownload();
static void serviceSdDownload();
static void handleSdDownload(const char* path, const char* downloadName, const char* contentType);
static void handleSend();
static void handleSerialCmd();
static void handleToneStatus();
static void handleI2cProbe();
static void handleToneTest();
static void handleToneCodecWrite();
static bool webBoolArg(const String& value);
static void handleNodeFavorite();
static void handleRoot();
static void handleFirmwareUpload();
static void handleFirmwareUpdateDone();
static bool validateWebNumericArgs();
static bool sdDownloadPathActive(const char* path);
static void initGames();
static void serviceGames();
static bool gamesMayLeavePage(lv_obj_t* target);
static bool uiReadInteractionActive();
static void updateGameBoyTouches(const uint8_t* points, size_t bytes);
static void clearGamesUiPointers();
static void registerGamesRoutes();
static void initDirectMessages();
static void openDirectConversation(uint32_t peer, bool legacy = false);
static void refreshDirectInbox();
static void markDirectConversationRead();
static void storeDirectConversation(uint32_t peer, const char* line, bool local);
static const char* currentDirectConversationText();
static uint32_t currentDirectPeer();
static void registerDirectMessageRoutes();
#ifdef FIRMWARE_RUN_TESTS
static void runWebMapTests();
#endif
