sintak15/s3-lora-interface/src/BuildIdentity.h

#pragma once
#if __has_include("../config/build_identity.generated.h")
#include "../config/build_identity.generated.h"
#endif
#ifndef FIRMWARE_GIT_COMMIT
#define FIRMWARE_GIT_COMMIT "unknown"
#endif
#ifndef FIRMWARE_SOURCE_DIRTY
#define FIRMWARE_SOURCE_DIRTY true
#endif
