sintak15/s3-lora-interface/(commit log)

2026-05-05 Add SD/offline map support and local GPS input
    Add offline map and SD card support plus a local GPS UART input and UI improvements.
    - README: document wiring, SD tile format (/s3-lora/tiles/<z>/<x>/<y>.rgb565), usage examples and helper scripts for generating tiles or rendering from .osm.pbf.
    - constants.h: add GPS UART pin config and SDMMC pin/frequency options for the LCDWiki ESP32-S3 display.
    - tools: add make_sd_tiles.py and osm_pbf_to_cyd_tiles helper scripts (and mbtiles sample) to build the firmware's required raw RGB565 tile layout.
    - s3-lora-interface.ino: integrate TinyGPS, SD_MMC filesystem mounting, SD logging (events, chats, positions), map cache structures and logic, UI change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
2026-05-06 Add WiFi AP control, chat persistence, landscape keyboard
    Introduce WiFi AP start/stop and stats (toggle count, uptime, stations) with UI pages and events; server is started/stopped with the AP and handleClient is gated by wifiEnabled. Add SD tail-loading for public/private chat logs and refresh views on load. Improve chat handling: remember recent local sends to suppress local-echo duplicates, timestamp and append chat messages to logs. Revamp battery sampling: track raw/filtered pack voltage, smooth estimates, better USB/charging detection and updated power state strings. Add landscape keyboard screen, touch coordinate remapping for landscape, UI rotation helper, and various small UI layou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
2026-05-06 Add backlight control UI and PWM support
    Introduce backlight controls and UI: add backlight state (backlightPercent, backlightPwmReady), initBacklight/applyBacklight, and slider event handler to adjust brightness (constrained 10–100%, default 80%). Add a Backlight page with a panel, slider, and status label; integrate it into the pages list and System menu via a new makeSystemTile helper used to replace several launcher/system action buttons with tiled buttons. Use ledcAttach/ledcWrite for PWM with an analogWrite fallback and display which method is active in the UI. Sync slider and label from refreshScreenUi and initialize backlight in initScreen.
    [s3-lora-interface.ino]
2026-05-06 Add web serial command and show GPS time
    Move initBacklight() to after tft.fillScreen to ensure backlight is initialized at the correct point. Replace the status label's frames count with local GPS time (converted to CDT) when available, otherwise show "Wait GPS". Add handleSerialCmd HTTP POST handler that validates a "cmd" arg, forwards the command to SerialLoRa (appending a newline), and returns appropriate status codes. Update the web UI to include a Serial Link input/button and a sendCmd() JS function, and register the /serial_cmd endpoint in setup().
    [s3-lora-interface.ino]
2026-05-06 Add configurable WiFi (AP/STA) UI & persistence
    Introduce Preferences-based persistence and dual-mode WiFi (AP/Station). Adds wifiIsApMode, wifiLocalSsid/wifiLocalPass and webui credentials stored in Preferences and loaded at boot; replace startWifiAp/stopWifiAp with startWifi/stopWifi to handle both modes. Add LVGL pages for Local Network and Scan Networks, text areas for SSID/password, Scan and Save buttons, async WiFi scan handling and a list of networks; polling is wired into loop(). Add an AP/Station switch in the WiFi page and update WiFi stats to reflect mode/IP/MAC appropriately. Implement checkAuth() to require web UI authentication when in STA mode and persist mode/credentials on c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
    [s3-lora-interface.ino]
2026-05-06 Add WiFi scan UI and optimize UI updates
    Update README with ESP32-S3 hardware target instructions. Major changes to s3-lora-interface.ino:
    - Add a dedicated WiFi scan page and controls (prev/next/select), store up to 16 scan SSIDs and render scan status/results asynchronously with pending/active state and timeouts.
    - Add a local credential editor with Direct/Save flow and persistent prefs for wifi/webui credentials (prefs now initialized earlier in setup).
    - Introduce helper functions setLabelTextIfChanged/setTextAreaTextIfChanged to avoid redundant LVGL updates and reduce flicker; many label/textarea updates now use these and are restricted to active pages.
    - Add landscape keyboard sync and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
    [s3-lora-interface.ino]
2026-05-06 Simplify WiFi to AP-only; remove prefs & auth
    Add an empty DisplayTest.ino placeholder and simplify s3-lora-interface.ino WiFi logic to AP-only. Removed Preferences/include and persistent STA credentials, plus web UI auth checks and related variables (wifiIsApMode, wifiLocalSsid/wifiLocalPass, webuiUser/webuiPass, prefs). Replaced start/stop/startWifi semantics with AP-specific startWifiAp/stopWifiAp, updated UI labels/stats to show AP info, removed WiFi scan/STA flows and pollWifiScan usage, and adjusted some layout sizes. Note: the diff contains unresolved merge conflict markers (<<<<<<< >>>>>>>) that must be resolved before this can be merged.
    [s3-lora-interface.ino]
2026-05-06 stable-5.6.26
    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
    [partitions.csv]
2026-05-06 Add PXL_20260506_204503228.RAW-01.jpg
    Add a new binary image file PXL_20260506_204503228.RAW-01.jpg to the repository. No code or text changes—just the added JPEG asset.
2026-05-06 Update description of the ESP32-S3 interface
2026-05-07 Add Web UI HTML and Heltec config APIs
    Introduce a dedicated Web UI asset and expand map/Heltec configuration functionality. Adds src/WebUi.h containing the full WEB_UI_HTML served from PROGMEM (replaces the large inline HTML in the root handler). Implements mapNearbyMode with UI buttons, nearest-node calculation (distanceMeters), node position updates (updateNodePosition) and logging/map render triggers. Refactors status JSON building into buildStatusJson and adds an SD snapshot endpoint (/sd/snapshot) plus a downloadable status snapshot path. Adds multiple parsing helpers for enum values and extends admin/config commands with new sendHeltec* helpers (serial, device, position, power) and up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
    [s3-lora-interface.ino]
2026-05-15 Add build options and a PowerShell script for serial communication
    - Created a new header file `build_opt.h` to include user setup and constants.
    - Added a PowerShell script `read_serial.ps1` for reading data from a specified serial port with configurable baud rate.
    [partitions.csv]
2026-05-15 Disable LiPo battery sensing, show external power
    Remove on-board LiPo ADC sensing and related estimation/calibration logic. Deleted BATT_ADC_PIN/BATT_ADC_MULTIPLIER defines and removed battery curve, smoothing, trend, calibration, and sampling functions; LocalBatteryStats was simplified (defaults to 100% / "ext power"). UI now displays "Ext Power" and a static 100% level. Also stop loading saved battery calibration on setup. Reason: the board's power is now provided via the MT3608 boost to the 5V rail, so the LiPo cannot be reliably read via the original divider.
2026-05-15 Clarify GPS wiring and 5V power rail
    Expand the Wiring section to show a shared boosted 5V rail: LiPo -> charger -> 5V boost -> Heltec 5V, ESP32-S3 display/CYD 5V, and GPS. Emphasize common ground and that GPS is powered from the boosted 5V (not the Heltec). Update GPS pin wiring (TX split to both boards, RX/TX mappings) and remove the previous suggestion to power GPS from the Heltec 3V3.
2026-05-15 Add node sorting and filtering functionality to the node list
    - Introduced NodeSortMode and NodeFilterMode enums to manage sorting and filtering options.
    - Implemented functions to cycle through sorting and filtering modes.
    - Updated the node list display to reflect the selected sorting and filtering criteria.
    - Added a new UI for sorting and filtering buttons on the nodes page.
    - Enhanced node detail display with range and bearing information.
    - Improved node matching logic based on filter criteria.
2026-05-20 Add plain-language use case to README
2026-05-20 Add web firmware upload OTA
    [enclosure_v2.scad]
2026-05-21 Stop tracking generated build artifacts
    [partitions.csv]
2026-05-21 Fix local Wi-Fi setup and enable scan feature
    - Enabled Wi-Fi scan functionality that was previously disabled.
    - Implemented missing SSID and Password fields in the local Wi-Fi setup page.
    - Updated Wi-Fi scan result click handlers to open local setup page and auto-focus password field.
    [s3-lora-interface.ino]
2026-06-07 Improve CYD UI diagnostics and battery handling
2026-06-07 Refine CYD battery curve alerts
2026-06-07 Extract status battery and storage JSON
2026-10-11 Harden firmware messaging, web UI, and SD transfers
    Reject invalid channels and numeric settings, escape dynamic HTML, recover timed-out serial frames, and serialize status refreshes with retries. Stream SD downloads between loop passes and protect downloaded snapshots from rewrites. Split firmware into focused modules, pin build configuration and vendored nanopb, add regression checks, and preserve existing local firmware enhancements in v0.1.79.
2026-10-17 Finalize v0.1.90 firmware, offline maps, and refreshed UI
    Serve SD maps and bundled viewer assets without an internet dependency, with
    imperial scales, coverage status, coarser fallback, panning and saved zoom.
    Add a bounded PSRAM tile cache, profiling, verified USB tile transfers and
    replacement-card download/copy tools.
    Refresh the touchscreen home dashboard and web interface, preserve uniform
    navigation, and harden battery rendering, delivery state and runtime reporting.
    Expose receiver-level GPS acquisition diagnostics separately from mesh traffic.
    Record completed firmware/browser checks, hardware validation and release
    artifact hashes in the documentation. The final GPS observation r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
2026-10-23 Add measured enclosure revisions, printable fit parts, and latest base plate
2026-10-23 Document CYD-owned GPS control and receive-only Heltec wiring
2026-10-23 Document GPIO wiring reference and project review findings
2026-10-23 Fix CYD audio playback and retain battery runtime learning
2026-10-23 Organize enclosure assets and clean repository conventions
2026-10-24 Use MAX battery readings and add readable SD power diagnostics
2026-10-24 feat: Implement power log rotation and battery symbol fonts
    - Added support for battery log rotation with a new PowerLogStorage structure.
    - Introduced battery symbol fonts for improved UI representation.
    - Updated UI to include a new page for viewing power logs and associated controls.
    - Enhanced battery cycle logging functionality with new status messages and rotation options.
    - Refactored SD card storage paths for better organization of power health logs.
    - Added tests for chat text formatting and log rotation functionality.
2026-10-25 Fix CYD scrolling and simplify power diagnostics
2026-10-25 Add rounded Material icons and shared blue UI styling
2026-11-07 Add sensor enclosure prototype and existing-case retrofit adapters
2026-11-08 Document core ATGM336H and ADS1115 wiring without auxiliary sensors
2026-11-08 Refresh current hardware docs for ATGM336H and ADS1115
2026-11-08 Add step-by-step beginner wiring instructions and meter checks
